Warpguru/LoRaIoT/doc/Architecture.md

# LoRaIoT - Firmware Architecture

This document is the developer reference for the LoRaIoT firmware internals.
For hardware wiring and operational guides see [`ReadMe.md`](../ReadMe.md); for worked
REST examples see [`RestApi.md`](RestApi.md#worked-examples).

---

## 1. Threading Model

To ensure that real-time RF communication never blocks the TCP/IP stack or HTTP/WebSocket
servers, LoRaIoT enforces a strict multi-threaded layout using FreeRTOS.

```
            Core 0 (System Core)                   Core 1 (Application Core)
     +---------------------------------+      +---------------------------------+
     | - WiFi Stack & LwIP             |      | - Main Arduino loop()           |
     | - ESPAsyncWebServer (Callbacks) |      |   applicationSetup/Loop()       |
     +---------------------------------+      |   (Priority 1)                  |
                      |                       | - loraTransportTask (Priority 2)|
                      |                       | - WSBroadcast (Priority 1)      |
                      |                       | - BeaconTask [REMOTE only]      |
                      |                       |   (Priority 1)                  |
                      |                       | - PingTask   (Priority 1)       |
                      |                       | - PushTask   (Priority 1)       |
                      |                       | - MqttTask [LOCAL only]         |
                      |                       |   (Priority 0)                  |
                      |                       +---------------------------------+
                      |                                        |
                      +======= [ txQueue (Serialized) ] =======+
                                         |
                                      UART2 -> E220
```

> On single-core builds all tasks run on the only available core with no affinity pinning.
> The `TASK_CREATE` macro in `src/util/src/TaskUtils.h` handles this automatically.

### Core Assignments

- **Core 0 (System Core):** Handles the high-frequency WiFi stack, TCP/IP processing, and
  non-blocking asynchronous web callbacks from `ESPAsyncWebServer` (REST API and WebSocket
  events). The WiFi stack serves one radio. In `AP_STA` mode the SoftAP and the station
  interface share it, so both interfaces run on the same channel.
- **Core 1 (Application Core):** Runs the primary application loop, the low-level
  `loraTransportTask`, WebSocket broadcast, PingTask, PushTask, and on REMOTE the
  beacon task. On LOCAL, `MqttTask` also runs here at the lowest user priority (0).

### Concurrency Rules

1. **Single UART2 Ownership:** The `loraTransportTask` is the **sole owner** of `LoRaSerial`
   (UART2). Web server callbacks on Core 0 must never write directly to UART2. The diagnostics
   engine borrows UART2 via `LoRaTransport.pause()` / `LoRaTransport.resume()`.
2. **The `txQueue` Bridge:** Any task intending to transmit calls `LoRaTransport.sendFrame()`
   or `LoRaTransport.sendRaw()`, which copies the packet into a `LoRaTxMessage` and posts it
   onto the FreeRTOS `txQueue`. The `loraTransportTask` drains the queue, executes the AUX
   handshake, and writes bytes atomically to UART2.
3. **LoRa Readiness Gate:** The `loraIsReady()` function (declared in `Application.h`) returns
   `true` only after the boot diagnostics have completed on the first `applicationLoop()` tick.
   Radio tasks (e.g. `BeaconTask`) must poll this before transmitting to avoid corrupting the
   E220 UART state during the diagnostics Mode 3 sequence.
4. **Shared State Mutexes:** All shared state structs (`LoRaState`, `SensorRegistry`,
   `ControlRegistry`, `LogBuffer`) are protected by FreeRTOS mutexes.
5. **Network I/O Tasks Must Run Below the Arduino Loop:** Any task that performs blocking
   TCP/socket I/O (e.g. `MqttTask`) must be assigned **priority 0** - strictly below the
   Arduino loop task (priority 1). See §8 for the full explanation.

---

## 2. LoRa Message Transmission and Reception Lifecycle

The diagram below details how requests from REST callbacks or background tasks are dispatched
across FreeRTOS queues to the single UART2 driver task, how AUX hardware flow control is
enforced, and how incoming frames are parsed, validated, and routed to application handlers.
The RX path shows both the synchronous response path (used when a Caller is blocking on a
reply) and the asynchronous application routing path (used for unsolicited frames such as
BEACON, DATA_ACK, and PING).

```mermaid
sequenceDiagram
    autonumber
    participant Caller as Caller Task / REST Handler
    participant Broker as LoRaBroker
    participant TxQ as txQueue (FreeRTOS Queue)
    participant Task as loraTransportTask (Core 1)
    participant E220 as Ebyte E220 Module (UART2)
    participant RxCB as onLoRaReceive Callback
    participant App as Application / Registry

    Note over Caller, E220: Outgoing Transmission Flow TX
    Caller->>Broker: loraBrokerSend(type, dstAddr, payload)
    Broker->>Broker: encodeFrame(LoRaFrame)
    Broker->>TxQ: xQueueSend(txQueue, LoRaTxMessage)
    Broker->>Broker: Block on responseSem (if waiting for reply)

    Task->>TxQ: xQueueReceive(txQueue, msg)
    Task->>E220: Poll AUX pin (wait until AUX is HIGH)
    Task->>E220: Atomic UART2 write: ADDH + ADDL + CHAN + Payload
    E220-->>Task: AUX drops LOW (transmission in flight)
    E220-->>Task: AUX rises HIGH (buffer empty)
    Task->>Task: Wait 50 ms RF guard delay (GUARD_DELAY_MS)
    Task->>Task: Increment statsTxFrames

    Note over E220, App: Incoming Reception Flow RX
    E220->>Task: UART2 RX bytes stream in
    Task->>Task: Sync scanner matches 0xAA 0x55
    Task->>Task: Accumulate header, payload, and CRC16
    Task->>Task: decodeFrame(rxBuffer) verifies CRC and DST
    Task->>Task: Increment statsRxFrames
    Task->>RxCB: onLoRaReceive(rxFrame)

    alt Frame is a RESPONSE or ACK matching a pending Caller
        RxCB->>Broker: loraBrokerOnResponse(response)
        Broker-->>Caller: Give responseSem and unblock caller
    else Unsolicited frame (BEACON, DATA_ACK, PING, DATA)
        RxCB->>App: Route by TYPE: update LoRaState, store in SensorRegistry / ControlRegistry
        App->>TxQ: Enqueue reply if required (ACK for DATA_ACK, ACK for PING, PING reply to BEACON)
    end
```

---

## 3. Boot Initialisation Sequence

The diagram below traces the exact sequence of steps from power-on (or reset after reflash)
until the node is fully ready to send and receive LoRa frames.

```mermaid
sequenceDiagram
    autonumber
    participant HW   as Hardware / Reset
    participant App  as applicationSetup
    participant Cfg  as LoRaConfig / WiFiConfig / Gateway / LogBuffer
    participant WM   as WiFiManager captive portal
    participant E220 as E220 Module UART2
    participant Task as loraTransportTask
    participant Diag as diagnosticsLoop
    participant Radio as Radio Tasks BeaconTask

    HW->>App: Power-on / reset

    Note over App,Cfg: Phase 1 - Singletons and NVS
    App->>App: statusLed.begin() - LED enters BOOTING state
    App->>Cfg: SensorRegistry.begin() / ControlRegistry.begin()
    App->>Cfg: LogBuffer.begin() - load persisted log level from NVS
    App->>Cfg: Gateway.begin() - load tier LOCAL / REMOTE from NVS
    App->>Cfg: LoRaConfig.begin() - load channel, address, cpuFreq from NVS
    App->>Cfg: WiFiConfig.begin() - load WiFi mode (STA / AP / AP_STA) and SoftAP settings from NVS
    App->>App: setCpuFrequencyMhz - apply saved CPU frequency

    Note over App,WM: Phase 2 - WiFi and Provisioning (branches on WiFiConfig mode)
    alt Mode is AP
        App->>App: WiFi.softAP - SoftAP up, WiFiManager bypassed, no captive portal
    else Mode is AP_STA
        App->>App: WiFi.softAP - SoftAP up first
        App->>WM: wm.autoConnect - join router
        Note over App,WM: If the router connection fails the node continues as SoftAP only
    else Mode is STA (default)
        App->>WM: wm.autoConnect - start WiFiManager
        alt Node is unprovisioned
            WM-->>App: Blocks - captive portal served on 192.168.4.1
            Note over WM: User selects Tier and Channel in browser
            WM->>Cfg: saveCallback - Gateway.save and LoRaConfig.save
        else Credentials already in NVS
            WM-->>App: Connects immediately, portal skipped
        end
        Note over App: A failed STA connection halts with the SOS LED
    end
    App->>App: RestService.registerRoutes - all /api/* routes wired
    App->>App: WebSocketService.begin - /ws/data handler active
    App->>App: server.begin - HTTP + WS live on port 80

    Note over App,E220: Phase 3 - E220 Hardware Init at 9600 baud Mode 3
    alt Gateway tier is configured
        App->>App: LoRaState.begin
        App->>App: LoRaTransport.setReceiveCallback
        App->>E220: LoRaTransport.begin
        E220-->>App: setMode M1=1 M0=1 - enter Config mode
        E220-->>App: Write C0 00 08 ADDH ADDL REG0 REG1 CH REG3 CRYPT_H CRYPT_L
        E220-->>App: Verify response != FF FF FF - retry up to 3x, FAULT on failure
        E220-->>App: setMode M1=0 M0=0 - Normal mode at 115200 baud
        App->>Task: TASK_CREATE loraTransportTask priority 2 - UART2 now owned
        App->>App: loraBrokerBegin - semaphore bridge initialised
        alt Tier is REMOTE
            App->>Radio: beaconTaskBegin - task created, polls loraIsReady before first TX
        end
        App->>App: statusLed setState READY
    else Tier not configured
        App->>App: statusLed setState NO_DEVICE - REST API still reachable
    end

    Note over App,Diag: Phase 4 - Boot Diagnostics and LoRa Gate
    App->>Diag: diagnosticsLoop - 6-step E220 wiring check + nanopb self-test
    Note over Diag: pause suspends loraTransportTask then resume restores it
    Diag-->>App: All steps logged to /api/log
    App->>App: loraReady = true - loraIsReady gate opens

    Note over Radio,Task: Phase 5 - Normal Operation
    Radio->>Radio: BeaconTask unblocks - loraIsReady returns true
    Radio->>Task: Enqueue BEACON frame onto txQueue
    Task->>E220: AUX handshake + atomic UART2 write
    Note over Task,E220: Node is fully operational - TX and RX active
```

---

## 4. Unified Singleton Design Pattern

The codebase is built around the **Arduino Singleton Pattern** to prevent global variable
name-shadowing collisions in C++ while presenting a clean, intuitive API. Every hardware
controller or configuration subsystem defines an underlying class with a `-Class` suffix and
exports a single global instance with a clean name:

- **`LoRaTransportClass` -> `LoRaTransport`**: Manages low-level UART2 transceiving, the
  FreeRTOS background task, and the `txQueue`.
- **`LoRaConfigClass` -> `LoRaConfig`**: Manages persistent NVS parameters (channel, address,
  CPU frequency).
- **`GatewayClass` -> `Gateway`**: Manages the persistent gateway role (`LOCAL` or `REMOTE`).
- **`LogBufferClass` -> `LogBuffer`**: Manages the multi-level (`INFO`/`DEBUG`/etc.) log ring
  buffer in RAM and provides JSON serialization.
- **`StatusLed` -> `statusLed`**: Manages the asynchronous status LED state machine.
- **`LoRaStateClass` -> `LoRaState`**: Mutex-protected per-SRC link state (duplicate
  detection, reboot detection via `boot_id`, LRU registry with 180s stale purge). Used on
  both LOCAL and REMOTE.
- **`PeerRegistry` -> `SensorRegistry`**: Manages sensor devices and metric definitions
  (owned on REMOTE, cached on LOCAL).
- **`PeerRegistry` -> `ControlRegistry`**: Manages control devices and setpoint definitions
  (owned on LOCAL, cached on REMOTE).

---

## 5. Browser Dashboard and WebSocket

Every node serves the same live dashboard at `GET /`. It is a single self-contained HTML page
(`src/LoRaIoT/src/index_html.h`, about 12 KB, inline CSS and JS, no CDN) stored in flash and sent
with `send_P()`, so it never occupies DRAM. After the page has loaded it needs no further HTTP
requests: all data arrives over one WebSocket, `ws://<host>/ws/data` (`WS_PATH` in `Server.h`).

The channel is **server push only**. The server never reads client messages (no `onEvent`
handler, no command queue), and the page sends nothing.

### Components

| Part | File | Role |
|---|---|---|
| `AsyncWebSocket ws(WS_PATH)` | `Server.cpp` | Endpoint, registered with `server.addHandler(&ws)` |
| `WebSocketService` (`wsService`) | `service/src/WebSocketService.cpp` | Owns `broadcastTask` (priority 1, 10240 B stack, `TaskRegistry` name `WSBroadcast`) |
| Dashboard page | `LoRaIoT/src/index_html.h` | WebSocket client, renders the JSON, handles link loss |

### Push path

```mermaid
sequenceDiagram
    participant B as Browser (index_html.h)
    participant W as ESPAsyncWebServer (Core 0)
    participant T as broadcastTask (1 s)
    participant R as Sensor/ControlRegistry
    B->>W: GET /
    W-->>B: INDEX_HTML from PROGMEM
    B->>W: WebSocket upgrade /ws/data
    loop every 1000 ms
        T->>T: ws->count() == 0 ? skip cycle
        T->>R: listPeers, getNodeInfo, getDeviceSlot (copies)
        T->>T: build JsonDocument, serializeJson
        T-->>B: ws->textAll(json)
        B->>B: render(), flash activity symbol
    end
```

`broadcastTask` only reads the in-RAM registry caches and never starts LoRa traffic. The air data
rate therefore does not limit the refresh rate, and values in the page are exactly as fresh as the
last frame the node received (`age_ms`, `peer_last_seen_ms_ago`).

### Payload

One JSON object per push; the full schema with an example is in
[`RestApi.md`](RestApi.md#websocket-wsdata) and in the header comment of `WebSocketService.cpp`.

| Field | Source |
|---|---|
| `uptime_s`, `tier` | `millis()`, `Gateway.getTierName()` |
| `lora` | `LoRaTransport.getStats()` (TX, RX, CRC errors, ACK loss) |
| `nodes[]` | **LOCAL:** `SensorRegistry` (sensor values cached from REMOTE nodes). **REMOTE:** `ControlRegistry` (setpoints cached from LOCAL). Same shape as `GET /api/lora/nodes/sensor` and `GET /api/lora/nodes/control`, `[]` if no peer is known |
| `echo` | `restServiceGetLastEcho()`, `null` until an echo test has run |

Design points:

- **String lifetime.** ArduinoJson stores `const char*` by pointer. `broadcastTask` therefore copies
  all `DeviceSlot` objects into a local array (`LORA_MAX_PEERS` x `DEVICE_TABLE_MAX_DEVICES`) before it
  builds the document, and keeps the array alive until `serializeJson()` returns.
- **Stack size.** That array is about 4 KB, so the stack is 10240 B. 6144 B overflowed and caused a
  stack canary panic. Check the high-water mark of `WSBroadcast` in `GET /status` when changing
  `LORA_MAX_PEERS` or the `DeviceTable` limits.
- **Idle cost.** With no client connected, the task skips the cycle before touching the registries
  or the JSON library.
- **Threading.** The task runs on Core 1 (the only core on single-core builds). The HTTP and
  WebSocket callbacks stay on Core 0 and do no LoRa or UART work, as required by the concurrency
  rules in section 1.

### Browser behaviour

| Behaviour | Implementation in the page |
|---|---|
| Reconnect | Exponential back-off, 1 s start, doubled per attempt, capped at 30 s; reset on a successful open |
| Dead-link detection | A powered-off or unplugged node sends no TCP close, so `onclose` never fires. A 1 s watchdog treats 3 s without a message as a lost link, closes the socket itself, shows "Disconnected" and starts the back-off reconnect |
| Stale data | When the link is lost the nodes are re-rendered as "unknown / link lost" with the age at the last update. The page does not claim online or offline, because it cannot know |
| Activity symbol | Flashes for 250 ms on every received message |
| Safe rendering | Node, device and metric names come from the radio link, so the DOM is built with `textContent` only, never `innerHTML` |

The online / offline badge of a node is the registry's liveness flag (`PingTask`: three unanswered
keep-alive PINGs after 90 s of silence, see [9.4](#94-ping-and-ack-both-nodes)). It is not derived from the
WebSocket. The WebSocket state ("Connected") and the node state ("online") are independent: the first
describes the link between browser and this node, the second the LoRa link between the two nodes.

### Limitations

- Read-only: the browser cannot change a setpoint over the WebSocket. Writes go through the REST API.
- `ws->cleanupClients()` is not called, so slots of clients that vanished without closing are
  reclaimed only by the async TCP stack.
- Each node shows only its own view: LOCAL does not display REMOTE's control cache and vice versa.

---

## 6. REST-to-Radio Message Flow (Control Setpoint Example)

This section traces the complete path of a write request - specifically a `POST /api/lora/nodes/control`
call on LOCAL - from the REST handler through every layer down to the physical E220 radio, and back.
It names every class, function, and file involved so a new developer can follow the code without
guessing. The data flow for sensor data (REMOTE to LOCAL) is the mirror image and follows the same
layers in the opposite direction.

### 6.1 Layer Stack

```
  POST /api/lora/nodes/control  (HTTP body: JSON)
           |
           v  Core 0 - ESPAsyncWebServer async_tcp task
  +-------------------------------+
  | RestService.cpp               |  src/service/src/RestService.cpp
  | registerRoutes() lambda       |  Validates input, writes to ControlRegistry,
  |                               |  calls loraSendDataReliable()
  +-------------------------------+
           |  calls
           v
  +-------------------------------+
  | LoRaBroker.cpp                |  src/LoRaIoT/src/LoRaBroker.cpp
  | loraSendDataReliable()        |  Encodes loraiot_Data with nanopb,
  | loraBrokerSend()              |  acquires brokerMutex, builds LoRaFrame,
  | loraBrokerWait()              |  calls LoRaTransport.sendFrame(),
  |                               |  then blocks on responseSem binary semaphore
  +-------------------------------+
           |  calls
           v
  +-------------------------------+
  | LoRaTransport.cpp             |  src/lora/src/LoRaTransport.cpp
  | sendFrame() -> sendRaw()      |  encodeFrame() -> copies LoRaTxMessage into
  |                               |  txQueue (FreeRTOS queue, depth 10)
  +-------------------------------+
           |  xQueueSend (thread-safe)
           v  Core 1 - loraTransportTask (priority 2, sole UART2 owner)
  +-------------------------------+
  | loraTransportTask loop        |  src/lora/src/LoRaTransport.cpp
  | sendRawInternal()             |  Drains txQueue, runs AUX handshake,
  |                               |  writes routing header + frame atomically to
  |                               |  LoRaSerial (HardwareSerial UART2, pins 16/17)
  +-------------------------------+
           |  GPIO 17 (TX2)
           v
  +-------------------------------+
  | E220-400T22D                  |  433 MHz LoRa, fixed transmission mode
  | RF over the air               |  Sub-packet 200 B, 62.5 kbps
  +-------------------------------+
           |  GPIO 16 (RX2) on REMOTE node
           v  Core 1 - loraTransportTask on REMOTE
  +-------------------------------+
  | loraTransportTask RX framer   |  src/lora/src/LoRaTransport.cpp
  |                               |  Sync scanner -> header accumulation ->
  |                               |  decodeFrame() CRC check -> receiveCallback
  +-------------------------------+
           |  calls
           v
  +-------------------------------+
  | Application.cpp               |  src/LoRaIoT/src/Application.cpp
  | onLoRaReceive()               |  Routes by frame TYPE; for DATA_ACK calls
  |                               |  cachedRegistry().storeData() then sendDataAck()
  +-------------------------------+
           |  sendDataAck() -> LoRaTransport.sendFrame() -> txQueue -> E220
           v  ACK frame travels back to LOCAL
  +-------------------------------+
  | onLoRaReceive() on LOCAL      |  Receives ACK frame, decodes loraiot_Ack,
  | -> loraBrokerOnDataAck()      |  calls loraBrokerOnDataAck() which
  |                               |  gives responseSem - unblocks RestService
  +-------------------------------+
           |
           v  Core 0 - RestService lambda resumes
  +-------------------------------+
  | RestService                   |  Maps BrokerResult to HTTP status
  | request->send(200/202/503/504)|  and calls request->send()
  +-------------------------------+
```

### 6.2 Concurrency Model in Detail

`ESPAsyncWebServer` delivers HTTP callbacks on Core 0 alongside the WiFi stack. The E220 module
is connected exclusively to `LoRaSerial` (`HardwareSerial LoRaSerial(2)`, UART2, GPIO 16/17).
`loraTransportTask` is created by `LoRaTransport.begin()` and is the only task that ever calls
`LoRaSerial.read()`, `LoRaSerial.write()`, or `LoRaSerial.begin()` during normal operation.
**A REST handler on Core 0 must never touch UART2 directly.**

The bridge between the two sides is:

1. **`txQueue`** - a FreeRTOS queue (depth `TX_QUEUE_SIZE` = 10, item type `LoRaTxMessage`).
   `LoRaTransport.sendRaw()` copies the encoded frame into a `LoRaTxMessage` and calls
   `xQueueSend()` with a short timeout. This is safe from any task or core.
   `loraTransportTask` drains the queue each loop iteration with `xQueueReceive()` using
   timeout 0 (non-blocking), then calls `sendRawInternal()`.
   The depth-10 capacity is **not** for pipelining multiple reliable sends - the broker
   single-slot constraint prevents that (see §6.8). It exists to absorb bursts of
   unsolicited outgoing frames (ACK replies, RESPONSE frames, BEACON frames) that
   `onLoRaReceive()` enqueues via `LoRaTransport.sendFrame()` while `loraTransportTask`
   is already inside `sendRawInternal()` for the current TX frame. These fire-and-forget
   frames bypass the broker and do not set `pendingActive`.

2. **`brokerMutex`** - a FreeRTOS mutex that guards the single in-flight slot in `LoRaBroker`.
   `loraBrokerSend()` try-acquires it with timeout 0; if it is held, it returns
   `BrokerResult::BUSY` immediately (no silent queuing). The mutex is released before the
   actual `LoRaTransport.sendFrame()` call to keep the critical section minimal.

3. **`responseSem`** - a FreeRTOS binary semaphore. After `loraBrokerSend()` returns `OK`, the
   caller immediately calls `loraBrokerWait(timeoutMs)`, which calls `xSemaphoreTake(responseSem, ticks)`.
   The calling task (the async_tcp task on Core 0) blocks here. When the matching ACK or RESPONSE
   frame arrives in `onLoRaReceive()` (running on Core 1 inside `loraTransportTask`), the receive
   path calls `loraBrokerOnDataAck()` or `loraBrokerOnResponse()`, which calls
   `xSemaphoreGive(responseSem)`, waking the waiting Core 0 task.

The default wait ceiling is `BROKER_DEFAULT_TIMEOUT_MS` = 3000 ms. The hard ceiling enforced by
the REST handler is `BROKER_MAX_TIMEOUT_MS` = 4000 ms, leaving 1000 ms headroom below the
ESP Task WDT default of 5000 ms. Calls to `loraBrokerWait()` that exceed the ceiling return
`BrokerResult::TIMEOUT`; the broker clears the pending slot so the next request is not blocked.

### 6.3 The AUX Pin Protocol

Every write to the E220 in `sendRawInternal()` follows this exact five-step sequence:

```
1. Poll AUX HIGH  - wait until digitalRead(PIN_AUX) == HIGH
                    (timeout AUX_TIMEOUT_MS = 1000 ms; warn and abort on timeout)
                    Ensures the module's internal FIFO is empty before we start.

2. Atomic write   - LoRaSerial.write(targetAddh)  <- routing header: ADDH
                    LoRaSerial.write(targetAddl)  <- routing header: ADDL (= dstAddr)
                    LoRaSerial.write(targetChan)  <- routing header: CH
                    LoRaSerial.write(data, len)   <- frame bytes (SYNC..CRC)
                    These four writes happen back-to-back with no delay between them.
                    Splitting them would risk the E220 force-flushing an incomplete frame
                    after its 2-second UART-inactivity timer.

3. Wait AUX LOW   - poll until digitalRead(PIN_AUX) == LOW
                    (timeout AUX_TRANSMIT_DETECT_TIMEOUT_MS = 50 ms; proceed on timeout)
                    AUX going LOW means the FIFO is accepting data from UART.

4. Wait AUX HIGH  - poll until digitalRead(PIN_AUX) == HIGH
                    (timeout AUX_TRANSMIT_COMPLETE_TIMEOUT_MS = 1000 ms; warn on timeout)
                    AUX returning HIGH means the FIFO has been handed to the RF chip.
                    NOTE: the last sub-packet may still be transmitting over the air
                    at this point (manufacturer §5.6.4).

5. Guard delay    - vTaskDelay(GUARD_DELAY_MS = 50 ms)
                    Mandatory air-time guard. Ensures the RF burst has finished before
                    the remote node can begin its ACK transmission.
```

Why this matters: the E220 has a 400-byte internal FIFO. If a second frame is written before the
first RF burst completes, the FIFO overflows and data is lost silently. The guard delay accounts
for the maximum air time of a maximum-length frame (200 B at 62.5 kbps takes roughly 30-50 ms
over the air).

### 6.4 DATA_ACK Retry Loop

`loraSendDataReliable()` (in `src/LoRaIoT/src/LoRaBroker.cpp`) implements reliability for
`DATA_ACK` frames:

```
maxAttempts = LORA_MAX_RETRIES + 1 = 4

for attempt in 0..3:
    if attempt > 0:
        wait random(LORA_BACKOFF_MIN_MS=20, LORA_BACKOFF_MAX_MS=200) ms
        re-arm pendingActive, pendingKind, pendingSeq (same SEQ reused)
    LoRaTransport.sendFrame(frame)          <- enqueues onto txQueue
    result = loraBrokerWait(LORA_ACK_TIMEOUT_MS=200 ms)
    if result == OK:
        outStatus = lastAckResult.status
        return OK

LoRaTransport.incrementAckLoss()            <- bumps statsAckLoss counter
outStatus = STATUS_BAD_REQUEST
return TIMEOUT
```

Key points:
- The SEQ number is assigned once before the loop and reused for all retransmissions.
  The receiver's duplicate-detection (`LoRaState.updateAndCheckDuplicate`) recognises a
  retransmitted DATA_ACK and re-sends the ACK without storing the data twice.
- Each attempt waits `LORA_ACK_TIMEOUT_MS` = 200 ms for the ACK. The timeout starts after
  the frame has been placed on `txQueue`; the actual air-time window begins a few milliseconds
  later when `loraTransportTask` drains the queue and completes the AUX handshake.
- A BUSY result (broker mutex taken) is returned immediately without entering the retry loop.
  The REST handler maps this to HTTP 503.

### 6.5 BrokerResult to HTTP Status Mapping

The `POST /api/lora/nodes/control` handler maps `loraSendDataReliable()` results to HTTP
status codes as follows (see `src/service/src/RestService.cpp`, the `/api/lora/nodes/control`
POST lambda):

| `loraSendDataReliable` result | ACK status | `delivery` field | HTTP status |
|---|---|---|---|
| `OK` | `STATUS_OK` | `"ok"` | 200 OK |
| `OK` but schema changed or `STATUS_BAD_REQUEST` ACK | `STATUS_BAD_REQUEST` | `"after_describe"` | 202 Accepted |
| `TIMEOUT` (all 4 retries failed) | - | `"timeout"` | 504 Gateway Timeout |
| `BUSY` (broker slot taken) | - | `"busy"` | 503 Service Unavailable |

- **200**: The setpoint was stored locally, transmitted, and acknowledged by REMOTE.
- **202**: The setpoint was stored locally. REMOTE acknowledged but returned `STATUS_BAD_REQUEST`,
  meaning it does not yet know the device schema. A Describe crawl has been triggered; the value
  will be pushed again by `PushTask` once the crawl completes.
- **504**: All four DATA_ACK attempts timed out with no ACK. The local value is still stored
  and will be retried by the `PushTask` when the link recovers or the next DATA_ACK opportunity
  arises.
- **503**: Another LoRa request is already in flight (the broker has a single slot matching the
  half-duplex LoRa channel). The caller should retry after a short delay.

### 6.6 Full Frame Lifecycle (DATA_ACK)

The numbered steps below correspond one-to-one with the `autonumber` labels in the sequence
diagram that follows. Each arrow in the diagram is one step.

1. REST client POSTs JSON `{"device":"Power-Supply","metrics":{"Voltage":{"value":1200,"unit":"V","scale":100}}}`.
2. `RestService` lambda (Core 0) parses the JSON, calls `ControlRegistry.registerMetric()` and
   `ControlRegistry.storeValue()` to persist the setpoint locally, and calls `ControlRegistry.toProtoData()`
   to serialise the device slot into a `loraiot_Data` protobuf struct.
3. `RestService` calls `loraSendDataReliable(dstAddr, loraiot_Data)` in `LoRaBroker`.
4. `loraSendDataReliable()` nanopb-encodes `loraiot_Data` into a byte buffer, wraps it in a
   `LoRaFrame` (TYPE=DATA_ACK, SRC=LOCAL, DST=addr, SEQ=N), acquires `brokerMutex` (try,
   timeout=0) and calls `LoRaTransport.sendFrame()`, which runs `encodeFrame()` (SYNC, VER, TYPE,
   SRC, DST, SEQ, LEN, CRC16) and `sendRaw()`, copying the result into a `LoRaTxMessage` and
   posting it onto `txQueue` via `xQueueSend()`.
5. `loraSendDataReliable()` calls `loraBrokerWait(200 ms)`, which calls
   `xSemaphoreTake(responseSem, ...)`. The async_tcp task on Core 0 blocks here until the
   semaphore is given or the timeout fires.
6. `loraTransportTask` (Core 1) drains `txQueue` with a non-blocking `xQueueReceive()`.
7. `loraTransportTask` calls `sendRawInternal()`, which first polls `PIN_AUX` until it reads HIGH
   (timeout `AUX_TIMEOUT_MS` = 1000 ms). AUX HIGH means the E220 FIFO is empty and ready.
8. `sendRawInternal()` writes the routing header (ADDH + ADDL + CH) followed immediately by the
   frame bytes (SYNC..CRC) as one atomic burst - no delays between the four `LoRaSerial.write()`
   calls.
9. E220 LOCAL drives AUX LOW: the FIFO has started accepting bytes from UART and is transferring
   them to the RF chip.
10. E220 LOCAL drives AUX HIGH: the FIFO has been handed to the RF chip. The last sub-packet may
    still be transmitting over the air at this point.
11. `sendRawInternal()` calls `vTaskDelay(GUARD_DELAY_MS = 50 ms)` to wait for the RF burst to
    finish before the channel is considered free again. `statsTxFrames` is incremented after the
    delay returns.
12. E220 LOCAL transmits the DATA_ACK frame over the 433 MHz LoRa link to E220 REMOTE.
13. E220 REMOTE outputs the received bytes on its UART2 (GPIO 16 RX2). REMOTE's
    `loraTransportTask` reads them via `LoRaSerial.read()`.
14. REMOTE's `loraTransportTask` runs the sync-byte framer: scans for `0xAA 0x55`, accumulates
    header and payload, then calls `decodeFrame()` which verifies the CRC16 and the DST address.
15. On a valid frame, `loraTransportTask` invokes `receiveCallback(rxFrame)`, which is
    `onLoRaReceive()` registered by `applicationSetup()`.
16. `onLoRaReceive()` on REMOTE decodes the `loraiot_Data` payload and calls
    `cachedRegistry().storeData()` to persist the setpoint.
17. `onLoRaReceive()` calls `sendDataAck(frame, STATUS_OK)`, which nanopb-encodes a `loraiot_Ack`,
    builds an ACK `LoRaFrame`, and calls `LoRaTransport.sendFrame()`, posting the ACK onto
    REMOTE's `txQueue`.
18. REMOTE's `loraTransportTask` picks up the ACK `LoRaTxMessage` from `txQueue` in its next
    loop iteration and calls `sendRawInternal()` to transmit it via the E220 AUX handshake.
19. E220 REMOTE transmits the ACK frame back over the 433 MHz LoRa link to E220 LOCAL.
20. E220 LOCAL outputs the ACK bytes on its UART2. LOCAL's `loraTransportTask` reads them via
    `LoRaSerial.read()`.
21. LOCAL's `loraTransportTask` runs the sync-byte framer on the incoming bytes, calls
    `decodeFrame()` (CRC check, DST check), and invokes `receiveCallback(rxFrame)`.
22. `onLoRaReceive()` on LOCAL decodes the `loraiot_Ack` payload and calls
    `loraBrokerOnDataAck(srcAddr, ack.status)`, which stores the result in `lastAckResult`,
    clears `pendingActive`, and calls `xSemaphoreGive(responseSem)`.
23. `xSemaphoreGive(responseSem)` unblocks the Core 0 async_tcp task. `loraBrokerWait()` returns
    `BrokerResult::OK` and `loraSendDataReliable()` returns `OK` with `outStatus = STATUS_OK`.
24. The REST lambda maps the result to HTTP 200 and calls `request->send(200, "application/json", json)`.

```mermaid
sequenceDiagram
    autonumber
    participant REST as REST Client
    participant Svc as RestService (Core 0)
    participant Reg as ControlRegistry
    participant Bkr as LoRaBroker
    participant TxQ as txQueue
    participant LT as loraTransportTask (Core 1)
    participant E220L as E220 LOCAL
    participant E220R as E220 REMOTE
    participant LTR as loraTransportTask REMOTE
    participant AppR as onLoRaReceive REMOTE
    participant RegR as ControlRegistry REMOTE

    REST->>Svc: POST /api/lora/nodes/control (JSON body)
    Svc->>Reg: registerMetric() + storeValue() + toProtoData()
    Svc->>Bkr: loraSendDataReliable(dstAddr, loraiot_Data)
    Bkr->>TxQ: nanopb-encode + brokerMutex(try) + sendFrame() -> sendRaw() -> xQueueSend
    Bkr->>Bkr: loraBrokerWait(200 ms) - xSemaphoreTake(responseSem)<br/>Core 0 async_tcp task BLOCKS

    LT->>TxQ: xQueueReceive (non-blocking)
    LT->>E220L: sendRawInternal: poll AUX HIGH
    LT->>E220L: atomic UART2 write (ADDH+ADDL+CH + frame bytes)
    E220L-->>LT: AUX LOW - FIFO filling
    E220L-->>LT: AUX HIGH - FIFO handed to RF chip
    LT->>LT: vTaskDelay(GUARD_DELAY_MS = 50 ms)

    E220L->>E220R: DATA_ACK frame over 433 MHz LoRa
    E220R->>LTR: UART2 RX bytes
    LTR->>LTR: sync scan 0xAA 0x55 - header + payload - decodeFrame() CRC check
    LTR->>AppR: receiveCallback(rxFrame)
    AppR->>RegR: cachedRegistry().storeData()
    AppR->>TxQ: sendDataAck() -> LoRaTransport.sendFrame() -> txQueue (REMOTE)
    LTR->>E220R: sendRawInternal - ACK frame over air
    E220R->>E220L: ACK frame over 433 MHz LoRa

    E220L->>LT: UART2 RX bytes (ACK)
    LT->>LT: framer - decodeFrame() - receiveCallback
    LT->>Bkr: loraBrokerOnDataAck(srcAddr, STATUS_OK)<br/>xSemaphoreGive(responseSem)
    Bkr-->>Svc: loraBrokerWait returns OK (Core 0 unblocks)
    Svc->>REST: HTTP 200 {"delivery":"ok"}
```

### 6.7 PingTask Indirect Path

`PingTask` (`src/LoRaIoT/src/PingTask.cpp`) does not call the REST handler but uses the same
broker. It is a standalone FreeRTOS task, so it can call `loraBrokerSend()` and block on
`loraBrokerWait()` without deadlocking the receive path.

The receive path (`loraTransportTask`) must never block waiting for the broker: doing so would
prevent the ACK from being processed, which would deadlock `loraBrokerWait()`. The solution is
the `beaconQueue` (depth `PING_QUEUE_LENGTH`): when `onLoRaReceive()` sees a BEACON it calls
`pingTaskNotifyBeacon(addr)` (posts to `beaconQueue` with timeout 0, never blocking) and returns
immediately. `pingTask` picks up the address from the queue and calls `loraBrokerSend()` /
`loraBrokerWait()` in its own context.

The same pattern applies to `pingTaskNotifyControlChange()`: the REST handler posts the node
address to `controlChangeQueue` (timeout 0, non-blocking) and returns. The `pingTask` drains
`controlChangeQueue` first on every loop iteration, before waiting on `beaconQueue`.

### 6.8 Single-Slot Guarantee and ACK Matching

#### Why only one request can be in flight at a time

The broker enforces a strict single-slot constraint regardless of the `txQueue` depth. Before
`loraSendDataReliable()` (or `loraBrokerSend()`) posts anything to `txQueue` it does:

```cpp
if (xSemaphoreTake(brokerMutex, 0) != pdTRUE) return BrokerResult::BUSY;  // mutex held
if (pendingActive)                             return BrokerResult::BUSY;  // slot occupied
// ... set pendingActive = true ...
xSemaphoreGive(brokerMutex);
LoRaTransport.sendFrame(frame);   // -> txQueue
loraBrokerWait(timeoutMs);        // blocks until ACK or timeout
```

The try-acquire (`timeout = 0`) means any concurrent caller - another REST handler, `PingTask`,
`BeaconTask` - receives `BUSY` immediately and never posts to `txQueue`. `pendingActive` stays
`true` for the entire duration of `loraBrokerWait()`, so the slot is occupied from the moment
the frame is enqueued until the ACK arrives or the timeout fires. As a result, at most one
broker-managed frame is ever present in `txQueue` at any given time.

The only frames that bypass this gate are unsolicited **fire-and-forget** replies generated
directly inside `onLoRaReceive()`: `sendPingAck()`, `sendDataAck()`, and `sendDescribeResponse()`.
These call `LoRaTransport.sendFrame()` directly, do not touch `pendingActive`, and can land in
`txQueue` concurrently with a pending broker request. `loraTransportTask` transmits them in
arrival order; the remote node will simply see them as independent frames on the channel.

#### How an ACK is matched to the pending request

`loraBrokerOnDataAck()` (called from `onLoRaReceive()` when an ACK for a DATA_ACK frame arrives)
checks only:

```cpp
bool match = pendingActive && (pendingKind == BROKER_KIND_DATA_ACK);
```

It does **not** compare `ack.acked_seq` against `pendingSeq`. This is safe for two reasons:

1. **Single-slot**: if `pendingActive` is true and `pendingKind` is `BROKER_KIND_DATA_ACK`,
   there is exactly one DATA_ACK exchange in flight. Any DATA_ACK ACK that arrives now must
   belong to it; there is no other in-flight DATA_ACK it could belong to.

2. **Same SEQ across retries**: `loraSendDataReliable()` assigns the SEQ once before the retry
   loop and reuses it for all retransmissions. So a late ACK from attempt N-1 that arrives
   during attempt N's `loraBrokerWait()` carries the same SEQ as the live attempt. The broker
   accepts it and unblocks the caller, which is the correct behaviour - one valid ACK is enough
   to declare success regardless of which physical transmission the remote node was replying to.
   The duplicate-detection on the remote side (`LoRaState.updateAndCheckDuplicate`) ensures the
   retransmitted frame is not applied to the registry twice.

A stale ACK from a **previous, already-completed** exchange cannot match because `pendingActive`
is cleared (by `loraBrokerOnDataAck()` on success, or by `loraBrokerWait()` on timeout) before
`loraSendDataReliable()` returns. By the time the next call enters, the stale ACK has long since
been received and discarded (the broker is no longer active for that kind).

---

## 7. Describe Crawl - Schema Discovery Before Data is Visible

### 7.1 Why a Crawl is Needed

LoRa frames are kept as small as possible to minimise air time and collision risk. A `DATA` or
`DATA_ACK` payload carries only compact integer values:

```
Data { device=1, values=[{metric_id=1, value=215}, {metric_id=2, value=483}] }
```

There are no strings, no units, and no human-readable names in the payload. The meaning of
`device=1`, `metric_id=1`, and the scale that turns `215` into `21.5 C` lives in a separate
**Device definition** (`Device { name="Env-Sensor", metrics=[{id=1, name="Temperature", unit="C", scale=10}, ...] }`),
which is owned by the node that produces the data and cached by the node that receives it.

Until that definition has been transferred, the receiving node cannot render the values
correctly. This transfer is the **Describe crawl**.

### 7.2 What Triggers a Crawl

Every BEACON frame (REMOTE to LOCAL) and every unicast PING frame carries an optional
`registry_rev` field - a counter that increments whenever a new device or metric is registered
on the owner node. The cache node watches this counter and schedules a crawl when it changes.

Three events set the `crawlPending` flag in `cachedRegistry()`, which `describeCrawlerLoop()`
picks up on the next `applicationLoop()` tick (all handled in `onLoRaReceive()` in
[`src/LoRaIoT/src/Application.cpp`](../src/LoRaIoT/src/Application.cpp)):

1. **New `boot_id`** - the peer has rebooted. The cache discards all state it held for that
   peer and starts a fresh crawl from device index 1. Set by `cachedRegistry().updatePeerMeta()`.
2. **`registry_rev` advanced** - a new device or metric was registered on the owner. A targeted
   crawl fetches the new definition without discarding existing ones. Set by
   `cachedRegistry().updatePeerMeta()`.
3. **DATA or DATA_ACK for an unknown device** - the cache node receives a value frame but does
   not yet have the schema for that device. `cachedRegistry().requestCrawl()` schedules an
   immediate crawl. For `DATA_ACK` the receiver additionally returns `STATUS_BAD_REQUEST` so
   the REST caller sees HTTP 202 (`"delivery":"after_describe"`).

On the sensor path, REMOTE now also calls `pingTaskNotifyControlChange(LOCAL)` whenever a
`POST /api/lora/sensor/data` increments `registry_rev`. This sends a PING to LOCAL carrying the
new `registry_rev` before the DATA frame is even transmitted, so LOCAL can start the crawl
before the data arrives rather than waiting for the next periodic BEACON.

### 7.3 The Crawl State Machine

The crawl is driven by `describeCrawlerLoop()` (in
[`src/LoRaIoT/src/DescribeCrawler.cpp`](../src/LoRaIoT/src/DescribeCrawler.cpp)), which is
called from `applicationLoop()` on every iteration. It manages one `CrawlerContext` struct:

```
IDLE ──(crawlPending detected in cachedRegistry())──► REQUESTING (deviceIdx = 1)
REQUESTING ──(RESPONSE(Device) received)──► REQUESTING (deviceIdx++)
REQUESTING ──(STATUS_BAD_REQUEST received)──► IDLE (crawl complete)
REQUESTING ──(timeout, all retries exhausted)──► IDLE (crawl aborted)
```

In `REQUESTING` state the crawler sends `REQUEST(Describe{device=deviceIdx})` directly via
`LoRaTransport.sendFrame()` - bypassing `LoRaBroker` intentionally, because the broker has a
single in-flight slot used by REST handlers and `PingTask`. The crawler manages its own
retry state (`DESCRIBE_RESPONSE_TIMEOUT_MS` = 3000 ms, `DESCRIBE_MAX_RETRIES` = 3 attempts
per device index).

`describeCrawlerOnResponse()` is called from `onLoRaReceive()` (inside `loraTransportTask`)
when a RESPONSE frame matches the in-flight Describe SEQ. It either advances `deviceIdx` and
sends the next request, or transitions back to `IDLE` on `STATUS_BAD_REQUEST`.

### 7.4 How the Owner Answers

The owner node receives `REQUEST(Describe{device=N})` in `onLoRaReceive()` and calls
`sendDescribeResponse()`, which looks up device index N in `ownedRegistry()` and replies with
`RESPONSE(Device)`. If N does not exist it replies with `STATUS_BAD_REQUEST`, signalling the
end of the device list to the crawling node.

Once the crawl-ending `STATUS_BAD_REQUEST` reply is sent, `sendDescribeResponse()` calls
`pushTaskNotifyCrawlComplete(peerAddr)`. This posts a notification to `PushTask`
([`src/LoRaIoT/src/PushTask.cpp`](../src/LoRaIoT/src/PushTask.cpp)), which then pushes the
current values of all owned devices to the peer as `DATA_ACK` frames. This ensures the cache
side receives both the schema and the current values in one crawl round.

### 7.5 Full Crawl Sequence

```mermaid
sequenceDiagram
    autonumber
    participant Own as Owner node (REMOTE for sensors / LOCAL for controls)
    participant Cache as Cache node (LOCAL for sensors / REMOTE for controls)
    participant Reg as cachedRegistry() on Cache
    participant DC as DescribeCrawler on Cache
    participant PT as PushTask on Owner

    Own->>Cache: BEACON or PING with registry_rev=N (new or changed)
    Cache->>Reg: updatePeerMeta(src, boot_id, registry_rev=N)
    Reg-->>Cache: crawlPending = true
    Note over Cache,DC: describeCrawlerLoop() picks up crawlPending on next applicationLoop() tick

    loop for deviceIdx = 1, 2, ... until BAD_REQUEST
        DC->>Own: REQUEST(Describe{device=deviceIdx}) via LoRaTransport.sendFrame()
        Own-->>DC: RESPONSE(Device{name, metrics}) or RESPONSE(STATUS_BAD_REQUEST)
        DC->>Reg: storeDevice(srcAddr, Device) - definition cached
    end

    Note over DC,Reg: STATUS_BAD_REQUEST received - crawl complete
    DC->>Reg: markCrawlComplete(addr, crawledRev)

    Own->>PT: pushTaskNotifyCrawlComplete(peerAddr)
    PT->>Cache: DATA_ACK for each owned device (current values)
    Cache->>Cache: cachedRegistry().storeData() - values now available
```

### 7.6 Visibility Delay for New Data

Because the schema must be crawled before values can be understood, there is an inherent delay
from the moment a new device or metric is registered until the data is visible on the cache
node's REST API and dashboard. The delay depends on how many devices are registered and the
current radio conditions:

| Phase | Typical duration |
|---|---|
| Owner notifies cache of new `registry_rev` | seconds: PING sent immediately on any schema change (both sensor and control paths) |
| Cache sets `crawlPending` and sends first `REQUEST(Describe{1})` | next `applicationLoop()` tick, < 10 ms |
| One `REQUEST(Describe)` round-trip at 62.5 kbps | ~100-200 ms per device (radio + processing) |
| `PushTask` pushes all device values after crawl completes | one `DATA_ACK` round-trip per device |

Both sensor and control paths now send an immediate PING carrying the new `registry_rev` the
moment a `POST` changes the schema:

- **Sensor data:** `POST /api/lora/sensor/data` calls `pingTaskNotifyControlChange(LOCAL)`
  when `registry_rev` increments, so LOCAL receives a PING and starts the crawl before the
  DATA frame even arrives over LoRa.
- **Control data:** `POST /api/lora/nodes/control` calls `pingTaskNotifyControlChange(addr)`,
  so REMOTE receives a PING and starts the crawl of LOCAL.
- **DATA with unknown device:** if a DATA frame arrives at the cache before the PING is
  processed, `cachedRegistry().requestCrawl()` in the DATA handler schedules the crawl
  immediately as a belt-and-suspenders fallback.

The BEACON interval is no longer on the critical path for new-schema latency. It remains
important for reboot detection and for the DISCOVERED/UNDISCOVERED state transition that
controls beacon rate.

Until the crawl completes, `GET /api/lora/nodes/sensor` (or `control`) on the cache node
returns the last known values or an empty list for the new device. The dashboard shows the
same cached state and will update automatically once the `PushTask` push arrives.

---

## 8. MQTT Telemetry Service

### 8.1 Overview

`MqttTask` (LOCAL tier only) runs the 256dpi `MQTTClient` library over a `WiFiClient` TCP
socket. It connects to the configured broker, publishes a retained `online` status message,
and then enters a loop that calls `client.loop()` (processes incoming MQTT packets) and
`drainPublishQueue()` (publishes queued telemetry) every `MQTT_LOOP_MS` (100 ms).

New telemetry is signalled from `loraTransportTask` via `MqttServiceClass::notifyPublish()`,
which uses a `portMUX_TYPE` spinlock to append an `(addr, deviceIdx)` entry to a fixed-size
pending array and then calls `xTaskNotifyGive()` to wake `MqttTask` early.

Incoming control setpoints (`<prefix>/Local/Remote_Node_<n>/<device>/<metric>/set`) follow the
opposite direction without ever blocking `MqttTask`: the 256dpi callback (invoked inside
`client.loop()` on `MqttTask`) only copies topic and payload into a small static queue. After
`client.loop()` returns, `MqttTask` parses it, updates `ControlRegistry` (the registry takes its
own mutex) and calls `pushTaskNotifySetpoint()`, a non-blocking queue send. `PushTask`
(priority 1) performs the blocking `loraSendDataReliable()`. `MqttTask` must never call
`loraSendDataReliable()` itself. The topic and payload format of the `/set` messages is
described in [8.6](#86-control-via-the-set-topic).

### 8.2 Why MqttTask Must Run at Priority 0

`MqttTask` must be assigned **priority 0** - strictly below the Arduino loop task (priority 1).

**The failure mode when run at priority 1:**

The boot sequence includes a diagnostics phase driven by `applicationLoop()` (the Arduino loop
task, priority 1, Core 1). `diagnosticsLoop()` calls `LoRaTransport.pause()`, which suspends
`loraTransportTask` and closes UART2, then runs the E220 wiring check, and finally calls
`LoRaTransport.resume()` to reopen UART2 and resume the transport task.

`MqttTask` is also on Core 1. With priority 1 and the MQTT broker reachable at boot, the
Arduino loop task did not complete its first `applicationLoop()` pass. The E220 check in
that pass suspends `loraTransportTask` and closes UART2 (`LoRaTransport.pause()`) and
reopens them at the end (`LoRaTransport.resume()`). If the pass never finishes, UART2 stays
closed and `loraTransportTask` stays suspended - zero LoRa RX for the whole session, and a
reboot does not help.

The symptom was observed in practice: after flashing the MQTT changes with the broker up,
`GET /api/lora/stats` showed `rx_frames=0` persistently (300+ seconds) and the log never
contained `applicationLoop: boot diagnostics complete - LoRa radio gate opened`, while
REMOTE was transmitting BEACONs every 5.5 s. With priority 0 the same code receives frames
normally.

The exact mechanism (a lock held across the blocking socket call versus plain scheduling)
is not proven; priority 0 is a verified workaround.

At priority 0, `MqttTask` is preempted by any priority-1 task the moment one becomes
runnable. The Arduino loop task always gets to complete `applicationLoop()` before `MqttTask`
resumes, and the diagnostics / LoRa gate sequence is never interrupted.

**The throughput impact is negligible:** `loraTransportTask` yields every 10 ms;
the Arduino loop yields whenever it calls `vTaskDelay` inside `describeCrawlerLoop()` and
`LoRaState.purgeStale()`. `MqttTask` gets CPU time far more often than the MQTT keepalive
interval (15 s) requires.

### 8.3 The `setOptions` Timeout Is in Milliseconds

The 256dpi `MQTTClient::setOptions(keepAlive, cleanSession, timeout)` takes `timeout` in
**milliseconds**. This timeout governs:
- How long `client.connect()` waits for a CONNACK from the broker.
- How long `client.publish()` waits for the TCP write to complete.
- The socket read loop inside `client.loop()`.

The constant `MQTT_CONNECT_TIMEOUT_MS = 5000` is in milliseconds and must be passed
**directly** to `setOptions`. Dividing it by 1000 produces `timeout = 5 ms`, which is far
too short for a WiFi TCP round-trip (typically 10-50 ms). The result is
`LWMQTT_MISSING_OR_WRONG_PACKET (-9)` on every connect attempt because the CONNACK never
arrives within 5 ms.

Correct call (in `MqttServiceClass::begin()`):
```cpp
client.setOptions(/*keepAlive=*/15, /*cleanSession=*/true,
                  /*timeout=*/MQTT_CONNECT_TIMEOUT_MS);   // 5000 ms, NOT /1000
```

### 8.4 Topic Case Sensitivity

MQTT topics are **case-sensitive**. The default prefix stored in NVS is `LoRaIoT`
(capital I, capital o, capital T as in the project name). Subscribers must match exactly:

```
# Correct
mosquitto_sub -t "LoRaIoT/#"
mosquitto_sub -t "LoRaIoT/Remote_Node_2/Today/#"

# Wrong - lowercase letters do not match
mosquitto_sub -t "LoRaIot/#"
```

The current prefix can always be verified with `GET /api/mqtt/config` (`mqttPrefix` field).

### 8.5 Topic scheme and payloads

Topic names are produced by `mqttSanitizeTopicLevel` in `MqttService.cpp`, which passes
`A-Z a-z 0-9 _ -` unchanged and replaces every other character (space, `%`, `/`, etc.)
with `_`. All values travel as scaled integers; the real value is `value / scale`. The rule
for registry names is also described in
[Sanitization Rule for Topic Levels](RestApi.md#sanitization-rule-for-topic-levels).

The node level of a REMOTE is `Remote_Node_<n>` with `n = addr - 1`. A REMOTE at LoRa address
`0x02` is therefore `Remote_Node_1` (the address is shown by `GET /api/lora/address` on the
node). The topic prefix is the `mqttPrefix` setting
([`GET /api/mqtt/config`](RestApi.md#get-apimqttconfig)); topics are case-sensitive, see
[8.4](#84-topic-case-sensitivity). The live connection state is reported by
[`GET /api/mqtt/status`](RestApi.md#get-apimqttstatus).

#### Topics published by LOCAL

LOCAL publishes each metric as a separate retained scalar topic. The payload is the real value
formatted by `mqttFormatScaledDecimal`: `215 / 10 = 21.5`, `483 / 10 = 48.3`.

| Topic | Payload | Retained | Direction | Notes |
|---|---|---|---|---|
| `LoRaIoT/Local/status` | `online` / `offline` | Yes (`online` follows `mqttRetain`; the broker publishes the `offline` last will retained) | LOCAL -> broker | Availability of LOCAL itself |
| `LoRaIoT/Remote_Node_1/status` | `online` / `offline` | Yes (`mqttRetain=1`) | LOCAL -> broker | `online` is published when REMOTE is first seen or returns from offline; `offline` when it is marked offline |
| `LoRaIoT/Remote_Node_1/Env-Sensor/Temperature` | `21.5` | Yes (`mqttRetain=1`) | LOCAL -> broker | scale 10: one decimal place |
| `LoRaIoT/Remote_Node_1/Env-Sensor/Humidity` | `48.3` | Yes (`mqttRetain=1`) | LOCAL -> broker | scale 10: one decimal place |
| `LoRaIoT/Remote_Node_1/Env-Sensor/AirPressure` | `incr.` | Yes (`mqttRetain=1`) | LOCAL -> broker | text metric: published verbatim |
| `LoRaIoT/Remote_Node_1/Env-Sensor/Firmware` | `1.10` | Yes (`mqttRetain=1`) | LOCAL -> broker | scale 100: two decimal places |
| `LoRaIoT/Remote_Node_1/Env-Sensor/Daylight` | `true` | Yes (`mqttRetain=1`) | LOCAL -> broker | boolean: stored and published as the text `true` / `false` |

All telemetry is published with `qos = 0` and `retain = true` (when `mqttRetain = 1`). All
names in this example (`Env-Sensor`, `Temperature`, `Humidity`, `AirPressure`, `Firmware`,
`Daylight`) pass the sanitizer unchanged - they contain only allowed characters. Note: the `%`
and `vers.` units are metadata only and never appear in a topic level, so they are not sanitized.

Scales 10, 100, 1000, 10000 and 100000 give 1 to 5 decimal places and scales of 1000000 and
above give 6; for any other scale (including 1 and 0) the stored integer is published
unchanged, without a decimal point. The payload of a text metric is the text verbatim.

The topic levels are built from the device and metric names of the cached definition, which
LOCAL fetches with the Describe crawl
([section 7](#7-describe-crawl---schema-discovery-before-data-is-visible)). Values of a device
or metric whose definition is not cached yet are not stored and therefore not published until
the crawl completes ([7.6](#76-visibility-delay-for-new-data)); after that the topics carry the
real names. Only a device or metric with an empty cached name is published under the fallback
levels `dev<idx>` / `m<id>`.

### 8.6 Control via the `/set` topic

LOCAL subscribes to a single wildcard filter right after connecting to the broker:

```
LoRaIoT/Local/+/+/+/set
```

This filter has five levels after the prefix (`Local`, node, device, metric, `set`); it follows
the configured `mqttPrefix`. It matches only command topics and never matches telemetry topics
(`LoRaIoT/Remote_Node_<n>/...`) or the availability topic (`LoRaIoT/Local/status`). LOCAL
subscribes to exactly one filter per broker session.

An external client publishes **one message per metric** (non-retained) to the corresponding
`/set` topic. How `MqttTask` hands the message over to `ControlRegistry` and `PushTask` is
described in [8.1](#81-overview). The JSON payload is parsed with `controlApplyMetric`, the
same function the REST handler uses. It is one metric object, identical to an entry
of the `metrics` map of [`POST /api/lora/nodes/control`](RestApi.md#post-apiloranodescontrol)
(field limits: [Request body schema and field limits](RestApi.md#request-body-schema-and-field-limits)).

#### /set Topic Pattern

```
<prefix>/Local/<node>/<device>/<metric>/set
```

For the Power Supply device on REMOTE (Node 1, address `0x02`):

| Topic | Example Payload | Direction | Notes |
|---|---|---|---|
| `LoRaIoT/Local/Remote_Node_1/Power-Supply/Voltage/set` | `{"value":1200,"unit":"V","scale":100}` | client -> LOCAL broker | numeric: scaled integer |
| `LoRaIoT/Local/Remote_Node_1/Power-Supply/Current/set` | `{"value":50,"unit":"A","scale":10}` | client -> LOCAL broker | numeric: scaled integer |
| `LoRaIoT/Local/Remote_Node_1/Power-Supply/Pwr/set` | `{"value":"on"}` | client -> LOCAL broker | text: no unit/scale needed |

`unit` and `scale` are optional in the payload (defaults: `""` and `1`). Numeric payloads must
include them if the metric is not yet registered in LOCAL's `ControlRegistry`, otherwise the
value is stored with scale 1. For an already registered metric the stored unit and scale are
kept and the ones in the payload are ignored.

The `/set` parser resolves topic names back to registry names by comparing their sanitized
forms. A device `"Power-Supply"` is stored in `ControlRegistry` as `"Power-Supply"`; the
hyphen is already valid in MQTT topic levels, so the sanitized topic level is identical to the
stored name: `Power-Supply`.

**Do not set the retain flag** (`-r`) on `/set` messages. The firmware discards any `/set`
message that arrives within `MQTT_SET_RETAINED_DRAIN_MS` (1 s) of a SUBSCRIBE, which is when
the broker replays retained messages. A retained `/set` would therefore be silently dropped on
every reconnect.

#### /set processing and limits

`MqttTask` handles each `/set` message in these steps (`messageReceived`, `processSetMessage`):

- **Dropped in the callback:** a topic of 96 characters or more (`MQTT_TOPIC_MAX_LEN`), a payload of 96 bytes or more (`MQTT_SET_PAYLOAD_MAX_LEN`), or a message that arrives while the queue already holds `MQTT_SET_QUEUE_LEN` (2) entries (logged as a warning).
- **First second after SUBSCRIBE:** every message in the window `MQTT_SET_RETAINED_DRAIN_MS` (1 s) is dropped, because the retained flag is not visible to the callback. This also drops a genuinely new, non-retained `/set` published in that first second after a (re)connect.
- **Failed SUBSCRIBE:** telemetry keeps working and the SUBSCRIBE is retried every `MQTT_SET_RESUBSCRIBE_MS` (30 s).
- **Topic:** the prefix is stripped and the rest is split into node, device, metric and `set`. A malformed topic is logged as an error and ignored; no error reply is published.
- **Node level:** `Remote_Node_<n>` with decimal digits only, no leading zero, `n` = 1..253 (LoRa address 2..254). The peer must be known in `SensorRegistry`, otherwise a warning is logged and the message is ignored.
- **Names:** resolved against `ControlRegistry` by sanitized comparison. An unknown device or metric is registered under the topic spelling. A topic name that sanitizing would change is rejected with an error log.
- **Payload:** must be a JSON object. It is passed to `controlApplyMetric`; if the schema changed, `pingTaskNotifyControlChange()` is called, then `pushTaskNotifySetpoint()`.
- **Numbers:** `value` is truncated to `int32`. Floats are not scaled; send the pre-scaled integer.
- **Not persisted:** `ControlRegistry` is held in RAM only (no NVS use in the registry or in `controlApplyMetric`). After a LOCAL reboot a `/set` registers the metric again, so `unit` and `scale` in that payload matter.

#### REMOTE-Side Result

LOCAL pushes the whole device (all metrics in `ControlRegistry` for that device) to REMOTE as
a DATA_ACK frame. REMOTE stores the values in its `ControlRegistry` cache. The IoT device on
REMOTE reads them with `GET /api/lora/nodes/control`. **Nothing is echoed back** on the `/set`
topic or on any state topic. When REMOTE's IoT device applies the setpoint and reports back via
`POST /api/lora/sensor/data`, LOCAL publishes the measured value on the normal telemetry topic
(`LoRaIoT/Remote_Node_1/...`), not on `/set`.

Each `/set` message triggers one independent LoRa push for the whole device. If the PushTask
queue (8 entries) is full, the push is dropped without retry; the next `/set` for that device
re-sends it, and a peer that comes back online or finishes a Describe crawl gets all its
devices pushed again (see [7.6](#76-visibility-delay-for-new-data) and
[9.7](#97-self-healing-after-an-outage)).

### 8.7 Worked MQTT examples

These examples continue the REST
[Worked Examples](RestApi.md#worked-examples), which also define the address placeholders
(`<broker>`, `<Local>`, `<Remote-Node-x>`, see
[Address placeholders](RestApi.md#address-placeholders)).

**Assumptions (both examples):**
- MQTT broker: `<broker>`, user and password as configured.
- MQTT prefix: `LoRaIoT` (default).
- Target REMOTE LoRa address: `0x02` (assumption - `Remote_Node_1`; confirm with
  `GET /api/lora/address` on the node). `n = addr - 1 = 1` (see [8.5](#85-topic-scheme-and-payloads)).
  Adjust `Remote_Node_<n>` in the topics below if the address differs (for example
  `Remote_Node_2` for a REMOTE at address `0x03`).
- `mqttRetain`: `1` (default) - all telemetry topics are published with `retain = true`.

#### Example 1 - Environmental Sensor: subscribe and see the topics

Scenario: the sensor board of
[REST Example 1](RestApi.md#example-1---environmental-sensor-remote-sensor-data-post) POSTs
its five readings to the REMOTE node. LOCAL receives the DATA_ACK frame over
LoRa and forwards each metric to the MQTT broker as a separate retained topic (see
[8.5](#85-topic-scheme-and-payloads)).

```bash
mosquitto_sub -h <broker> -u <user> -P <password> \
  -t 'LoRaIoT/Remote_Node_1/#' -v
```

Expected output lines (order depends on which messages arrive first):

```
LoRaIoT/Remote_Node_1/status online
LoRaIoT/Remote_Node_1/Env-Sensor/Temperature 21.5
LoRaIoT/Remote_Node_1/Env-Sensor/Humidity 48.3
LoRaIoT/Remote_Node_1/Env-Sensor/AirPressure incr.
LoRaIoT/Remote_Node_1/Env-Sensor/Firmware 1.10
LoRaIoT/Remote_Node_1/Env-Sensor/Daylight true
```

Because retain is enabled, re-running `mosquitto_sub` after the node has sent data will
immediately replay the last retained value for each topic.

#### Example 2 - Power Supply Control: set values with `mosquitto_pub`

Scenario: an MQTT client pushes the same setpoints as
[REST Example 2](RestApi.md#example-2---power-supply-control-local-control-setpoint-post)
via the `/set` topic (see [8.6](#86-control-via-the-set-topic)), without calling the REST API.

Set voltage to 12.00 V (non-retained):

```bash
mosquitto_pub -h <broker> -u <user> -P <password> \
  -t 'LoRaIoT/Local/Remote_Node_1/Power-Supply/Voltage/set' \
  -m '{"value":1200,"unit":"V","scale":100}'
```

Set current limit to 5.0 A (non-retained):

```bash
mosquitto_pub -h <broker> -u <user> -P <password> \
  -t 'LoRaIoT/Local/Remote_Node_1/Power-Supply/Current/set' \
  -m '{"value":50,"unit":"A","scale":10}'
```

Turn power on (text metric, non-retained):

```bash
mosquitto_pub -h <broker> -u <user> -P <password> \
  -t 'LoRaIoT/Local/Remote_Node_1/Power-Supply/Pwr/set' \
  -m '{"value":"on"}'
```

Turn power off:

```bash
mosquitto_pub -h <broker> -u <user> -P <password> \
  -t 'LoRaIoT/Local/Remote_Node_1/Power-Supply/Pwr/set' \
  -m '{"value":"off"}'
```

Do not add `-r` (retain); see the retain rule in [8.6](#86-control-via-the-set-topic).

### 8.8 Session, availability and hand-off details

- **Session:** the MQTT client ID is `LoRaIoT-<6 hex digits>` (low 24 bits of the efuse MAC), with `cleanSession=true` and `keepAlive=15`.
- **Last will:** only LOCAL's own `<prefix>/Local/status` has a Last Will (`offline`, retained, qos 0). There is no Last Will per REMOTE. After a LOCAL crash the retained per-peer values are corrected on the next connect (all peers are republished). A graceful disconnect, or a configuration change, publishes a retained `offline` for `<prefix>/Local/status` first.
- **Telemetry hand-off:** `notifyPublish()` keeps at most `MQTT_PENDING_MAX` (12) `(addr, deviceIdx)` entries, de-duplicated under the spinlock. When the array is full the entry is dropped and `publishDropCount` is incremented. Entries pending while the broker is not connected are discarded.
- **Per-peer status hand-off:** `mqttServiceNotifyPeerStatus()` is called by `Application.cpp` (a REMOTE comes back online, or a BEACON creates a new peer) and by `PingTask.cpp` (a REMOTE is marked offline). It is a no-op on REMOTE. There are `MQTT_PEER_STATUS_MAX` (3, equal to `LORA_MAX_PEERS`) slots. The latest state wins and notifications coalesce. The published payload is derived from `SensorRegistry.getLiveness()` at publish time. A failed publish stays pending and is retried.
- **Stack and buffer:** `MQTT_TASK_STACK_SIZE` is 5120 bytes and `MQTT_CLIENT_BUFFER_SIZE` is 256 bytes. Both are first estimates, not measured; `GET /status` reports the real stack high-water mark of `MqttTask`.

---

## 9. Runtime Behaviour

This section describes the communication lifecycle that starts after provisioning. It covers
E220 initialisation, boot diagnostics, the beacon-based discovery protocol, liveness checking,
sensor and control data flows, and the self-healing behaviour after an outage.

### 9.1 E220 Initialisation

On boot, the ESP32 configures the E220 in Mode 3 (9600 baud) writing the persistent register
block (`REG0=0xE7`, `REG1=0x00`, `REG3=0x40`), then returns to Mode 0 (115200 baud). The
`loraTransportTask` starts and owns UART2 exclusively from this point. For the register
meanings see [LoRaProtocol.md §2](LoRaProtocol.md#2-radio-configuration-normative).

### 9.2 Boot Diagnostics

On the first `applicationLoop()` tick, the 6-step E220 wiring check runs automatically
(Mode 3 register read/write/verify + nanopb + frame codec self-tests). The `loraIsReady()`
gate opens only after this completes, allowing `BeaconTask` and other radio tasks to start
transmitting.

### 9.3 BEACON and Discovery (REMOTE)

The REMOTE beacon state machine (UNDISCOVERED and DISCOVERED states, beacon intervals, revert
rule) and the LOCAL rules are specified in
[LoRaProtocol.md §8](LoRaProtocol.md#8-beacon-and-discovery).

On the first received BEACON, LOCAL registers the REMOTE node in `SensorRegistry` (via
`cachedRegistry()`) and schedules a definition crawl
([`REQUEST(Describe)`](LoRaProtocol.md#12-device-identity-and-definitions)) to learn the
REMOTE's sensor device definitions.

### 9.4 PING and ACK (both nodes)

The PING rules (keep-alive, `boot_id`, `registry_rev`) are specified in
[LoRaProtocol.md §8](LoRaProtocol.md#8-beacon-and-discovery) and
[LoRaProtocol.md §6.1](LoRaProtocol.md#61-reboot-detection-boot_id).

Both tiers run `PingTask`. LOCAL sends a liveness check
([`PING`](LoRaProtocol.md#5-message-types)) to REMOTE on BEACON reception or on demand via
REST, REMOTE sends keep-alive PINGs to LOCAL, and the sender logs the RTT of the framed `ACK`
reply.

### 9.5 Sensor Data Push (REMOTE)

- An IoT sensor on REMOTE (via its SoftAP in `AP` / `AP_STA` mode, or its LAN address in
  `STA` mode) POSTs readings to `POST /api/lora/sensor/data`. REMOTE stores them in
  `SensorRegistry` and increments `registry_rev` when the schema changes.
- When `registry_rev` changes, REMOTE immediately sends a PING to LOCAL carrying the new
  revision. LOCAL fetches the updated definitions from REMOTE over LoRa (definition crawl,
  [`REQUEST(Describe)`](LoRaProtocol.md#12-device-identity-and-definitions)), then REMOTE's
  `PushTask` pushes the current values as confirmed data frames
  ([`DATA_ACK`](LoRaProtocol.md#5-message-types)).
- A LAN client reads the values from LOCAL via `GET /api/lora/nodes/sensor?addr=2`.

See [LoRaProtocol.md §15, End-to-end scenario A](LoRaProtocol.md#end-to-end-scenario-a---iot-sensor-on-remote-softap-pushes-data-to-local)
for the full sequence diagram.

### 9.6 Control Setpoint Push (LOCAL) and Retrieval (REMOTE)

- A LAN controller POSTs a setpoint to LOCAL via `POST /api/lora/nodes/control?addr=2`. LOCAL
  stores it in `ControlRegistry` and immediately pushes it to REMOTE as a confirmed data frame
  ([`DATA_ACK`](LoRaProtocol.md#5-message-types)). If REMOTE acknowledges, LOCAL returns
  `200 {"delivery":"ok"}`.
- If REMOTE is unreachable at the time of the POST, LOCAL returns `504 {"delivery":"timeout"}`
  but **keeps the setpoint in `ControlRegistry`**. The value is re-delivered automatically
  once REMOTE comes back online (see §9.7 below).
- If REMOTE does not yet recognise the control device (e.g. after its own reboot), it tells
  LOCAL it needs the definitions first
  ([`ACK{status=BAD_REQUEST}`](LoRaProtocol.md#5-message-types)) and fetches them from LOCAL
  via a definition crawl
  ([`REQUEST(Describe)`](LoRaProtocol.md#12-device-identity-and-definitions)). LOCAL returns
  `202 {"delivery":"after_describe"}`. Once the crawl completes, LOCAL's `PushTask` re-pushes
  the stored value as a confirmed data frame
  ([`DATA_ACK`](LoRaProtocol.md#5-message-types)) without any further action from the caller.
- REMOTE caches the setpoint in its `ControlRegistry`. An IoT device on REMOTE (SoftAP or LAN
  address) reads the current setpoint via `GET /api/lora/nodes/control`.

See [LoRaProtocol.md §15, End-to-end scenario B](LoRaProtocol.md#end-to-end-scenario-b---controller-on-local-lan-pushes-a-setpoint-to-remote-iot-sensor-retrieves-it)
for the full sequence diagrams for both scenarios.

### 9.7 Self-Healing After an Outage

- **REMOTE reboots or is temporarily out of range:** REMOTE resets its `boot_id` and reverts
  to fast BEACON every 5 s. LOCAL detects the new `boot_id` on the first received BEACON,
  clears its cached sensor registry for that node, sends a liveness check
  ([`PING`](LoRaProtocol.md#5-message-types)) carrying `registry_rev` if LOCAL has control
  devices, and starts a fresh definition crawl
  ([`REQUEST(Describe)`](LoRaProtocol.md#12-device-identity-and-definitions)). Once the crawl
  completes, both `PushTask` instances re-deliver the latest values in each direction - REMOTE
  pushes its current sensor readings and LOCAL pushes its stored control setpoints. No manual
  intervention is needed.
- **LOCAL reboots:** LOCAL sends a broadcast liveness check
  ([`PING`](LoRaProtocol.md#5-message-types)) at boot carrying its new `boot_id`. REMOTE
  detects the new `boot_id`, clears its cached control registry, and fetches the definitions
  from LOCAL via a definition crawl
  ([`REQUEST(Describe)`](LoRaProtocol.md#12-device-identity-and-definitions)). After the
  crawl, LOCAL's `PushTask` re-delivers the control setpoints.
- **Temporary RF loss (no reboot):** Both nodes run `PingTask`. After 90 s of silence, each
  node sends keep-alive PINGs to the peer. After three unanswered PINGs the peer is marked
  `online: false` in the REST views. As soon as any frame is received, the peer is immediately
  revived (`online: true`) and normal operation continues with no re-crawl needed (the
  `boot_id` has not changed, so cached definitions remain valid).
- **Entry purge and re-entry:** If no frame is received for 180 s (three missed slow
  beacons), LOCAL purges the registry entry entirely. REMOTE re-enters through its fast-beacon
  cycle, which triggers a full rediscovery as described above.

### 9.8 Fixed-Mode Routing

The E220 fixed-mode routing header, broadcast address, and Mode 3 register writes are
specified in [LoRaProtocol.md §2](LoRaProtocol.md#2-radio-configuration-normative).

### 9.9 REST and WebSocket API

The REST API and the WebSocket push endpoint are documented in
[doc/RestApi.md](RestApi.md) and [Architecture.md §5](#5-browser-dashboard-and-websocket).

---

## 10. E220 Interface and Diagnostics

The pin mapping between the ESP32 and the E220 is in [ReadMe.md](../ReadMe.md#canonical-pin-mapping).

### 10.1 E220 Hardware Operating Modes

By driving the M0 and M1 pins, the ESP32 dynamically commands the E220 through different operating states:

| M1 Pin | M0 Pin | Mode | Purpose | UART Baud Rate | Description |
|:---:|:---:|:---:|---|:---:|---|
| **LOW** | **LOW** | **Mode 0** | Normal / Transceive | **115200** (Configured) | Active RF transceiving. E220 handles RF-to-UART conversion. |
| **LOW** | **HIGH** | **Mode 1** | WOR (Wake on Radio) | 115200 | Power-saving mode. Receives and transmits WOR preambles. |
| **HIGH** | **LOW** | **Mode 2** | WOR Power Save | 115200 | Puts E220 RX to sleep, waking up periodically to sense preambles. |
| **HIGH** | **HIGH** | **Mode 3** | Config / Deep Sleep | **9600** (Fixed) | Accept registers read/write commands over UART. |

### 10.2 On-Demand Diagnostics and Multi-Node Debugging

Since serial monitors can typically only focus on a single COM port at a time, LoRaIoT integrates tools to trace and isolate physical wiring faults or airframe issues over the local network.

#### The 6-Step Hardware Diagnostics Check

The diagnostics run automatically at boot and can be re-triggered at any time via REST
([`GET /api/diag/e220`](RestApi.md#get-apidiage220)):

**Trigger the check on demand** (run on each node you want to test - replace with `<LOCAL-IP>` or `<REMOTE-IP>`):
```bash
curl -s http://<LOCAL-IP>/api/diag/e220
curl -s http://<REMOTE-IP>/api/diag/e220
```
*This safely calls `LoRaTransport.pause()` to suspend the background transceiver task before touching UART2, and `LoRaTransport.resume()` when done.*

**Fetch the results from each node:**
```bash
curl -s http://<LOCAL-IP>/api/log
curl -s http://<REMOTE-IP>/api/log
```

Look for `E220 diag:` lines in the log. The six steps and their failure interpretations:

| Step | What is tested | Fail diagnosis |
|---|---|---|
| 1 | AUX reads HIGH in Mode 0 (idle) | No power to E220 (check VCC/GND) or AUX wire loose/stuck |
| 2 | AUX returns HIGH after entering Mode 3 (M1=1, M0=1) | M0 or M1 control line disconnected |
| 3 | Read all 8 registers (`C1 00 08`) - response is not `FF FF FF` | RXD/TXD lines loose, swapped, or another task is holding UART2 |
| 4 | Temp-write a different channel (`C2`), read back, compare | Register write path broken - E220 flash worn or SPI conflict |
| 5 | Temp-write original values back (`C2`), read back, compare | Values did not round-trip - likely a UART noise or timing issue |
| 6 | Return to Mode 0 - AUX rises HIGH again | M0/M1 lines intermittent or AUX stuck LOW after mode switch |

Steps 4 and 5 use the **temporary write command `0xC2`** - nothing is stored in the E220's flash, so a power cycle always restores the previous configuration.

#### Multi-Node Log Comparison

```bash
curl -s http://<local_ip>/api/log
curl -s http://<remote_ip>/api/log
```
