Warpguru/LoRaIoT/doc/private/doc-refactoring-plan.md

# Documentation Refactoring Plan

## Overview

**Goal:** a qualitative improvement of the existing documentation without adding, removing or
substantially rewriting content. Only structure, placement and references change.

**Audience split:**

- `ReadMe.md` is for a newcomer (for example on GitHub): what the project is, how it works, what
  it needs, how to get started. Plain language, with enough technical facts to judge fit.
  Detail is available through collapsible `<details>` sections, compact by default.
- All other live documents are for a technical specialist who clones the project and changes it.

**Approach:** each sub-task below is one small, separately reviewable change. After each one,
stop and wait for the user's review before starting the next.

## Decisions made by the user

- `doc/IoTProtocol.md` content is distributed to other documents and the file is then deleted.
- `doc/images/LoRaIoT-flow.png` goes into the executive summary part of `ReadMe.md`.
- ReadMe sections 1 to 3 (summary, hardware requirements, wiring) stay in `ReadMe.md`, using
  collapsible sections for a compact default view. The E220 operating-mode table moves out.
- Factual errors found in `ReadMe.md` are corrected.
- The `ReadMe.md` introduction reuses the plain wording of `FAQ.md`.
- The file name `ReadMe.md` is kept. Links pointing at `README.md` are fixed.
- The MQTT topic scheme and examples move to `doc/Architecture.md`, into the existing MQTT
  chapter (section 8) as new sub-sections. A new chapter is created only if no existing one fits.
- Unifying the example names (to those of `IoTProtocol.md`) is the LAST step, together with a
  fact verification of the MQTT content whose outcome is decided later.
- When the draw.io source of the flow diagram is corrected, the user re-exports the PNG.

## Frozen documents (decided by the user)

These files are never modified, never linked to from live documents, and nothing is moved into
them. Reading them as a source to copy facts from is allowed.

- Dead documentation: `doc/Feasibility.md`, `doc/MqttFeasibility.md`, `doc/CiFeasibility.md`
- `doc/Learnings.md` (also never referenced from other documents)
- `doc/TechDebt.md`
- `doc/private/**`, `mqtt-plan.md`
- `AGENTS.md`, `.bob/**`, `ESP/**`

Consequence: live documents currently pointing to `doc/MqttFeasibility.md`, `doc/Feasibility.md`
or `doc/Learnings.md` lose those references. Where such a pointer was the only place describing a
fact, the fact gets a live home (sub-task 7).

## Ground rules (apply to every sub-task)

- Do not renumber existing sections of a target document. Append new sections at the end, so
  existing section numbers and anchors stay valid (`FAQ.md` links to an `Architecture.md`
  anchor; `AGENTS.md` cites section numbers).
- If a target document already says the same thing, the moved text is replaced by a link. Each
  fact lives exactly once.
- Moved text is kept verbatim except for minimal link and reference fixes.
- No em dash or en dash anywhere. Use `-`.
- Do not build, flash or call `GET /reset`. Documentation work needs none of that.

## Target structure after the refactoring

| Document | Audience | Role |
|---|---|---|
| `ReadMe.md` | newcomer | Pitch, flow image, how it works, short examples, MQTT summary, dashboard, WiFi modes, hardware, getting started, antenna tips, documentation map |
| `FAQ.md` | user | unchanged except for link fixes |
| `doc/RestApi.md` | integrator | endpoints, plus request schema and limits, worked REST examples |
| `doc/Architecture.md` | specialist | threading, boot, runtime behaviour, E220 interface and diagnostics, MQTT service (threading constraints, topic scheme, examples) |
| `doc/LoRaProtocol.md` | specialist | wire spec, plus air rate and link budget theory |
| `doc/IoTProtocol.md` | - | deleted |

---

## Sub-task 1 - Correct the factual errors in ReadMe.md

**Intent:** fix known-wrong statements first, in place, so later steps are pure moves.

**Expected outcomes:** `ReadMe.md` agrees with the code and with `doc/LoRaProtocol.md`.

**Todo list:**
1. Section 5 Phase 2: change "default Channel 25 / `0x19`" to channel 23 / `0x17`. The range 0-31 is correct (`LORA_MAX_CHANNEL = 31`).
2. Section 5 Phase 3 item 7: change "After 60 s of silence" to 90 s (`PING_IDLE_THRESHOLD_MS`).
3. Re-read Phase 3 items 3 to 7 once against `doc/LoRaProtocol.md` sections 6.1 and 8 for further numeric mismatches. Report findings, fix only clear errors.
4. The introduction wording ("transparently extend local IP networks", "enterprise-grade") is NOT changed here. It is rewritten in sub-task 11.

**Relevant context:** `ReadMe.md` lines 247, 278; `src/LoRaIoT/src/LoRaConfig.h` (`LORA_DEFAULT_CHANNEL`, `LORA_MAX_CHANNEL`); `src/LoRaIoT/src/PingTask.h` (`PING_IDLE_THRESHOLD_MS`); `doc/LoRaProtocol.md` sections 6.1, 8.

**Status:** [x] done

**Note for later sub-tasks:** only lines 247 and 278 of `ReadMe.md` changed (channel 23 / `0x17`, keep-alive 90 s). Phase 3 items 3 to 7 were cross-checked and all other numbers match the code and `doc/LoRaProtocol.md` (5 s / 60 s beacons, 2 min revert = `BEACON_REVERT_TIMEOUT_MS`, 3 ping attempts, 180 s purge = `LORA_STATE_STALE_MS`). Line numbers in the "Relevant context" of later sub-tasks are unchanged because no lines were added or removed.

---

## Sub-task 2 - Move the runtime behaviour from the ReadMe into Architecture.md

**Intent:** the communication lifecycle (ReadMe section 5, Phase 3) is firmware behaviour for specialists.

**Expected outcomes:** new section "9. Runtime Behaviour" appended to `doc/Architecture.md`. In `ReadMe.md`, Phase 3 is replaced by a short summary and a link.

**Todo list:**
1. Append "9. Runtime Behaviour" with the content of Phase 3 items 1 to 7 (E220 init, boot diagnostics, beacon and discovery, ping and ack, sensor push, control push, self-healing).
2. Where `doc/LoRaProtocol.md` sections 6.1, 8 or 15 already contain the same rule or sequence, reduce the text to a link. Keep text that exists only in the ReadMe (for example the three self-healing scenarios and the `200/202/504` delivery results).
3. Fix relative links inside the moved text (`doc/LoRaProtocol.md` becomes `LoRaProtocol.md`).
4. Replace Phase 3 in `ReadMe.md` with a 3 to 4 line summary and a link. Phase 1 and 2 (build, flash, provision) stay.
5. Phase 3 item 8 (fixed-mode routing) is already in `doc/LoRaProtocol.md` section 2: link only. Item 9 (REST and WebSocket) is already in `doc/RestApi.md` and `Architecture.md` section 5: link only.

**Relevant context:** `ReadMe.md` lines 254-283; `doc/Architecture.md` (currently ends with section 8); `doc/LoRaProtocol.md` sections 2, 6.1, 8, 15.

**Status:** [x] done

**Note for later sub-tasks:** `ReadMe.md` Phase 3 is now 11 lines (was 30 lines). The heading
"### Phase 3: Run & Communicate" is at approximately line 254; the removal of ~22 lines
shifts everything from line 287 onward downward. Sub-task 3 uses `ReadMe.md` lines 197-207
and 445-485 - those lines are now approximately 197-207 and 423-463 respectively. Re-locate
by heading ("E220 Hardware Operating Modes", "7. On-Demand Diagnostics") rather than by line
number. `doc/Architecture.md` section 9 starts at line 951; the file previously ended at
line 948.

---

## Sub-task 3 - Move the E220 interface and diagnostics into Architecture.md

**Intent:** the E220 operating-mode table and the 6-step diagnostics are specialist material.

**Expected outcomes:** new section "10. E220 Interface and Diagnostics" appended to `doc/Architecture.md`. `ReadMe.md` keeps the pin mapping table (a builder needs it) and gets a short troubleshooting pointer.

**Todo list:**
1. Move the ReadMe "E220 Hardware Operating Modes" table to the new section. Do not replace it with a link into `doc/Feasibility.md` (frozen).
2. Move ReadMe section 7 (6-step diagnostics table, the `LoRaTransport.pause()/resume()` note, multi-node log comparison) to the same section.
3. In `ReadMe.md`, replace section 7 with a 3 line "Troubleshooting" text: call `GET /api/diag/e220`, read `GET /api/log`, link to the Architecture section.

**Relevant context:** `ReadMe.md` lines 197-207 and 445-485; `doc/Architecture.md`; `doc/RestApi.md` (`GET /api/diag/e220`).

**Status:** [x] done

**Note for later sub-tasks:** `doc/Architecture.md` now ends with "## 10. E220 Interface and Diagnostics" (10.1 E220 Hardware Operating Modes; 10.2 On-Demand Diagnostics and Multi-Node Debugging with the 6-step table, `pause()/resume()` note, `0xC2` note and Multi-Node Log Comparison). It links to `RestApi.md#get-apidiage220` and `../ReadMe.md#canonical-pin-mapping`. Em dashes in the moved text were replaced by `-`. In `ReadMe.md` the heading "### E220 Hardware Operating Modes" (section 3) is kept with a one-line pointer to Architecture §10.1, and "## 7. On-Demand Diagnostics & Multi-Node Debugging" became "## 7. Troubleshooting" (3 lines, links to Architecture §10.2). ReadMe section numbering is unchanged; no file links to the old section 7 or E220 mode table anchors. ReadMe section 7 shrank from about 36 to 5 lines, so section 8 and the glossary appendix moved up by about 31 lines: re-locate by heading. Sub-task 11 may fold "7. Troubleshooting" and the one-line "E220 Hardware Operating Modes" pointer into the new structure (and must then keep the links in the Architecture section 10 intro, which targets `ReadMe.md#canonical-pin-mapping`, valid). `AGENTS.md` line 121 cites `README.md` §3 for the pin mapping (frozen, unchanged; the pin mapping is still in section 3).

---

## Sub-task 4 - Move the air rate theory into LoRaProtocol.md

**Intent:** link budget and register constants are specialist material; antenna placement stays for installers.

**Expected outcomes:** new sub-section "Link budget and air rate selection" appended to section 18 of `doc/LoRaProtocol.md` (last section, nothing renumbered). `ReadMe.md` keeps the antenna rule and one sentence on air rate with a link.

**Todo list:**
1. Move ReadMe section 8 rule 2 (link budget, dB figures, `REG0` constants) into section 18.
2. Keep the existing `PUT /api/lora/airrate` reference.
3. Keep rule 1 (parallel-tilt antenna rule) in `ReadMe.md`.
4. ReadMe keeps one sentence: lowering the air rate trades throughput for range, with a link to `doc/LoRaProtocol.md` section 18.

**Relevant context:** `ReadMe.md` lines 486-502; `doc/LoRaProtocol.md` section 18.

**Status:** [x] done

**Note for later sub-tasks:** `doc/LoRaProtocol.md` section 18 now ends with sub-section `### Link budget and air rate selection` (lines 781-794), covering the mathematical coupling of sensitivity to spreading factor/bandwidth, `REG0` constants (`REG0_AIR_DATA_RATE_62K5` to `REG0_AIR_DATA_RATE_2K4`, $+14\text{ dB}$ link budget increase), the $6\text{ dB}$ range/penetration doubling rule, `PUT /api/lora/airrate`, and internal links to the test results and timeout note above. In `ReadMe.md` section 8, rule 1 (`1. The Parallel-Tilt Antenna Rule`) remains unchanged; rule 2 (`2. Dropping Air Data Rate for Link Budget Gains`) was reduced to two sentences stating that lowering air rate via `PUT /api/lora/airrate` trades throughput for range and linking to `doc/LoRaProtocol.md#link-budget-and-air-rate-selection`. No lines were added/removed from ReadMe.md that would affect earlier sections; section 8 is now lines 427-440.

---

## Sub-task 5 - Move the request schema and field limits into RestApi.md

**Intent:** the "Request Body Schema and Field Limits" part of `IoTProtocol.md` is API reference material.

**Expected outcomes:** `doc/RestApi.md` documents the shared JSON body, field table, topic-level sanitization rule and capacity limits table (with `DeviceTable.h` constants), next to the two endpoints that use it.

**Todo list:**
1. Add the schema, field reference, sanitization rule and capacity table as a sub-section of `POST /api/lora/sensor/data`. Refer to it from `POST /api/lora/nodes/control` (no duplication).
2. Merge with the existing "Value types" list in `POST /api/lora/sensor/data`. Remove only exact duplicates.
3. Keep the HTTP 400 and `rejected` array behaviour description.
4. Add an anchor that other documents can link to.

**Relevant context:** `doc/IoTProtocol.md` lines 30-90; `doc/RestApi.md` sections `POST /api/lora/sensor/data`, `POST /api/lora/nodes/control`; `src/registry/src/DeviceTable.h`.

**Status:** [x] done

**Note for later sub-tasks:** the schema now lives in `doc/RestApi.md` as `### Request body schema and field limits`, the last sub-section of `POST /api/lora/sensor/data` (with `#### Field Reference`, `#### Sanitization Rule for Topic Levels` and the `<details>` capacity table). GitHub anchor to link to: `#request-body-schema-and-field-limits` (from `doc/Architecture.md` and other documents: `RestApi.md#request-body-schema-and-field-limits`). The old "Value types" lists in `POST /api/lora/sensor/data` and `POST /api/lora/nodes/control` were replaced by one-line references to that anchor. The sub-section mentions the MQTT `/set` payload and topic levels neutrally and has no link to MQTT anchors: sub-task 7 may add a link from the Sanitization Rule to Architecture 8.5/8.6. Sub-task 6 should link its examples to this anchor. The two `MqttFeasibility.md` pointers in `RestApi.md` (in `POST /api/lora/nodes/control` and in the MQTT section) are untouched (sub-task 7). `doc/IoTProtocol.md` was not modified.

---

## Sub-task 6 - Move the REST worked examples into RestApi.md

**Intent:** curl examples, expected responses and notes of `IoTProtocol.md` belong with the API reference.

**Expected outcomes:** new section "Worked Examples" at the end of `doc/RestApi.md` with the placeholder table (`<Local>`, `<Remote-Node-x>`, `<broker>`), the REST part of Example 1 (sensor POST) and Example 2 (control POST), bash and PowerShell variants, expected responses and notes.

**Todo list:**
1. Append "Worked Examples". Keep the `<details>` blocks as in the source.
2. Move the placeholder reference.
3. Move the example responses, status code notes (`200`, `202`, `503`, `504`) and the notes lists. Skip MQTT parts (sub-task 7).
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
