Warpguru/LoRaIoT/doc/private/mqtt-plan.md

# MQTT Integration Implementation Plan

**Goal:** Implement lightweight MQTT telemetry forwarding (LoRa to MQTT) and setpoint subscription (MQTT to LoRa) on the LOCAL node using a hierarchical topic tree and non-blocking FreeRTOS architecture.

---

## Architecture Overview

- **Target Node:** LOCAL node only (REMOTE nodes remain unaware of MQTT).
- **Placement:** `MqttService.cpp/.h` in `src/service/` (consistent with `WebSocketService`, `RestService`, and `WiFiConfig`).
- **Core Library:** `256dpi/MQTT @ ^2.5.3` (plain TCP, synchronous client inside dedicated task, ~10 KB flash).
- **Threading Model:** Dedicated FreeRTOS task `mqttTask` (priority 0 on Core 1, strictly below the Arduino loop task; priority 1 stalled the LoRa boot sequence, see `doc/Learnings.md` chapter 1) with non-blocking spinlock pending-set hand-off (depth 12 with de-duplication) bridging `loraTransportTask` and MQTT network I/O.
- **Failure Isolation:** Non-blocking pending-set hand-off ensures an unreachable or failing MQTT broker never blocks LoRa reception (`loraTransportTask`), the WiFi stack, or Core 0 web callbacks.
- **Topic Scheme:** `<prefix>/<node>/<device>/<metric>` where `<node>` is textual `Remote_Node_<n>` and `n` is the dashboard node number (`n = LoRa address - 1`, so `REMOTE (Node 1)` = address 0x02 = `Remote_Node_1`, e.g. `LoRaIoT/Remote_Node_1/SensorA/Voltage`), publishing scaled real decimal strings with `retain = true`.
- **Availability / LWT:** Broker Last Will and Testament (LWT) on `<prefix>/Local/status` (`offline` on ungraceful disconnect, `online` on connect) and per-node availability on `<prefix>/Remote_Node_<n>/status`.
- **Control Path:** Setpoint subscription on `<prefix>/Local/+/+/+/set` (topic `<prefix>/Local/Remote_Node_<n>/<device>/<metric>/set`, JSON payload identical to one metric object of `POST /api/lora/nodes/control`) translating into `ControlRegistry` updates and a per-device `PushTask` hand-off that transmits a `DATA_ACK` frame.

---

## Sub-Tasks

### Sub-Task 1: Library Dependency and MqttService Task Engine

- **Intent:** Add `256dpi/arduino-mqtt` library and implement minimal `MqttService` skeleton with a dedicated Core 1 FreeRTOS task to measure exact flash and heap usage before further feature implementation.
- **Expected Outcomes:**
  - `platformio.ini` includes `256dpi/MQTT @ ^2.5.3`.
  - `src/service/src/MqttService.h` and `src/service/src/MqttService.cpp` scaffolded.
  - `mqttServiceBegin()` invoked only on LOCAL nodes in `Application.cpp:applicationSetup()`.
  - Task `mqttTask` runs on Core 1 (`TASK_CREATE`, stack size 4096 bytes, priority 0) and registers with `TaskRegistry.add()`.
  - Connection management with exponential backoff and LWT (`<prefix>/Local/status` = `offline`).
  - Flash image size and heap headroom verified immediately after linking.
- **Todo List:**
  - [x] Add `256dpi/MQTT @ ^2.5.2` to `platformio.ini` under `[env]` `lib_deps`.
  - [x] Create `src/service/src/MqttService.h` and `src/service/src/MqttService.cpp`.
  - [x] Implement `mqttServiceBegin()` and hook into `Application.cpp:applicationSetup()`.
  - [x] Implement `mqttTask` skeleton with `TASK_CREATE`, `TaskRegistry.add()`, and `MQTTClient` instance.
  - [x] Configure LWT and broker connection loop.
  - [x] Verify build size and resource footprint on hardware (to be done by developer).
- **Relevant Context:**
  - [`src/service/src/WebSocketService.cpp`](src/service/src/WebSocketService.cpp:1)
  - [`src/util/src/TaskUtils.h`](src/util/src/TaskUtils.h:1) (`TASK_CREATE` macro)
- **Status:** `[x] done (LWT, connection loop, NVS config, REST API implemented; awaiting developer build & resource check)`

---
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
