Warpguru/LoRaIoT/doc/images/ESP32-WROOM-32.jpg

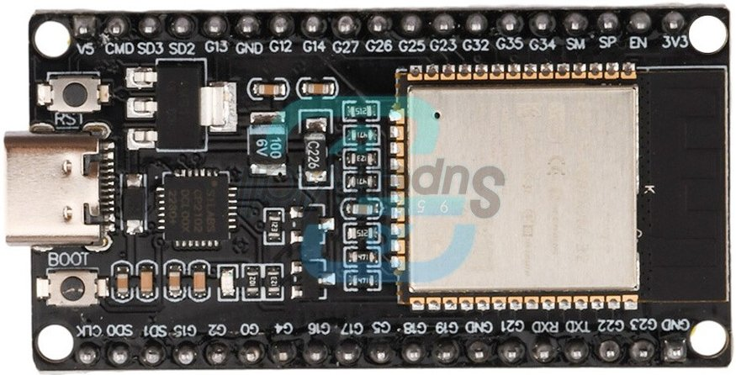
doc/images/ESP32-WROOM-32.jpg
