Warpguru/LoRaIoT/doc/images/ESP32-WROOM-32.webp

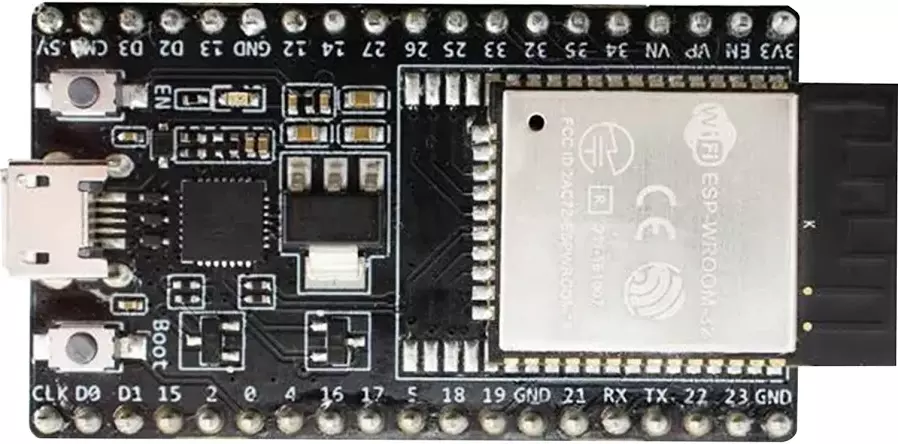
doc/images/ESP32-WROOM-32.webp
