Warpguru/LoRaIoT/src/lora/src/LoRaTransport.cpp

#include "LoRaTransport.h"

#include <Arduino.h>
#include <HardwareSerial.h>

#include "../../diagnostics/src/TaskRegistry.h"
#include "../../util/src/LogBuffer.h"
#include "../../util/src/StatusLed.h"
#include "../../util/src/TaskUtils.h"
#include "../../LoRaIoT/src/LoRaConfig.h"

// Hardware Serial object mapped to UART2
HardwareSerial LoRaSerial(2);

// The actual global memory allocation for the LoRa transport layer singleton.
// All application-level files include "LoRaTransport.h" and interact with this object.
LoRaTransportClass LoRaTransport;

static constexpr size_t HEX_LOG_BUFFER_SIZE = 128;  // Output buffer for logHex()

// Label and REG0 bits of every AirRate, indexed by the enum ordinal (which is what is stored in NVS).
struct AirRateInfo {
  const char* name;
  uint8_t     reg0;
};
static constexpr AirRateInfo AIR_RATE_TABLE[LoRaTransportClass::AIR_RATE_COUNT] = {
    {"2.4k",  LoRaTransportClass::REG0_AIR_DATA_RATE_2K4},    // AIR_RATE_2K4
    {"4.8k",  LoRaTransportClass::REG0_AIR_DATA_RATE_4K8},    // AIR_RATE_4K8
    {"9.6k",  LoRaTransportClass::REG0_AIR_DATA_RATE_9K6},    // AIR_RATE_9K6
    {"19.2k", LoRaTransportClass::REG0_AIR_DATA_RATE_19K2},   // AIR_RATE_19K2
    {"38.4k", LoRaTransportClass::REG0_AIR_DATA_RATE_38K4},   // AIR_RATE_38K4
    {"62.5k", LoRaTransportClass::REG0_AIR_DATA_RATE_62K5},   // AIR_RATE_62K5
};

const char* LoRaTransportClass::airRateName(AirRate rate) {
  return AIR_RATE_TABLE[rate].name;
}

uint8_t LoRaTransportClass::airRateReg0(AirRate rate) {
  return AIR_RATE_TABLE[rate].reg0;
}

bool LoRaTransportClass::airRateFromName(const char* name, AirRate& out) {
  if (name == nullptr) {
    return false;
  }
  for (uint8_t i = 0; i < AIR_RATE_COUNT; i++) {
    if (strcmp(AIR_RATE_TABLE[i].name, name) == 0) {
      out = static_cast<AirRate>(i);
      return true;
    }
  }
  return false;
}

/**
 * Reusable helper to format and log a byte array in hexadecimal.
 */
static void logHex(const char* prefix, const uint8_t* data, size_t len) {
  char hex[HEX_LOG_BUFFER_SIZE] = {0};
  size_t pos = 0;
  for (size_t i = 0; i < len && pos + LoRaTransportClass::HEX_ENTRY_SIZE < sizeof(hex); i++) {
    pos += snprintf(hex + pos, sizeof(hex) - pos, "%02X ", data[i]);
  }
  Log_info("%s %s", prefix, hex);
}

bool LoRaTransportClass::configureE220() {
  const AirRate airRate = LoRaConfig.getAirRate();
  Log_info("Configuring E220 module registers permanently in Mode 3 (air rate %s)...", airRateName(airRate));
  setMode(HIGH, HIGH); // M1=1, M0=1

  // Start serial at 9600 baud (fixed for E220 config mode). end() first: at runtime the
  // port is open at NORMAL_BAUD; at boot it is a harmless no-op.
  LoRaSerial.end();
  LoRaSerial.begin(CONFIG_BAUD, SERIAL_8N1, PIN_RX, PIN_TX);

  // Construct the command payload to permanently configure the E220.
  // Using explicit bitwise-OR options makes the config list completely self-documenting.
  // Split the 16-bit key into the two CRYPT register bytes.
  // key == 0 leaves CRYPT_H=0x00 / CRYPT_L=0x00, which disables E220 encryption.
  const uint16_t loraKey = LoRaConfig.getKey();
  uint8_t configCmd[CONFIG_CMD_LEN] = {
      CMD_WRITE_PERSISTENT,
      REG_START_ADDR,
      REG_WRITE_COUNT,
      ADDH,
      LoRaConfig.getAddress(),
      (REG0_UART_BAUD_115200 | REG0_PARITY_8N1 | airRateReg0(airRate)),
      (REG1_SUB_PACKET_200B | REG1_RSSI_NOISE_DISABLE | REG1_POWER_22DBM),
      LoRaConfig.getChannel(),
      (REG3_MODE_FIXED | REG3_RSSI_BYTE_DISABLE | REG3_LBT_DISABLE),
      static_cast<uint8_t>(loraKey >> 8),    // CRYPT_H
      static_cast<uint8_t>(loraKey & 0xFF)   // CRYPT_L
  };

  logHex("LoRaTransport::begin - Sent config cmd:", configCmd, CONFIG_CMD_LEN);

  // Write config and verify response; retry up to LORA_MAX_RETRIES times on
  // FF FF FF error reply or short read.
  bool configOk = false;
  for (uint8_t attempt = 0; attempt < LORA_MAX_RETRIES; attempt++) {
    // AUX must be HIGH and stable before writing config data
    unsigned long settleStart = millis();
    while (digitalRead(PIN_AUX) == LOW) {
      if (millis() - settleStart > AUX_TIMEOUT_MS) {
        Log_error("LoRaTransport::begin - Timeout waiting for AUX HIGH before config write (attempt %u/%u)",
                  attempt + 1, (uint8_t)LORA_MAX_RETRIES);
        break;
      }
      delay(POLL_INTERVAL_MS);
    }
    delay(GUARD_SETTLE_DELAY_MS);

    // Write configuration command
    LoRaSerial.write(configCmd, CONFIG_CMD_LEN);
    delay(TRANSMIT_SETTLE_DELAY_MS);

    // Read response (should echo C1 00 08 ...)
    uint8_t response[CONFIG_RESPONSE_LEN] = {0};
    size_t bytesRead = LoRaSerial.readBytes(response, CONFIG_RESPONSE_LEN);

    logHex("LoRaTransport::begin - Config response:", response, bytesRead);

    if (bytesRead >= CONFIG_RESPONSE_LEN && response[0] != ERROR_REPLY_BYTE) {
      Log_info("LoRaTransport::begin - E220 configuration applied successfully (attempt %u/%u).",
               attempt + 1, (uint8_t)LORA_MAX_RETRIES);
      configOk = true;
      break;
    }

    Log_error("LoRaTransport::begin - Invalid config response (attempt %u/%u); retrying...",
              attempt + 1, (uint8_t)LORA_MAX_RETRIES);
    delay(GUARD_SETTLE_DELAY_MS);
  }

  // Return to Mode 0 (Normal operation: M1=0, M0=0) and configure normal baud rate,
  // also after a failure so the radio keeps running with its previous registers.
  setMode(LOW, LOW);
  LoRaSerial.end();

  // Re-open serial at 115200 baud (as configured in REG0)
  LoRaSerial.begin(NORMAL_BAUD, SERIAL_8N1, PIN_RX, PIN_TX);
  return configOk;
}

void LoRaTransportClass::requestReconfigure() {
  reconfigRequested.store(true);
}

void LoRaTransportClass::begin() {
  Log_info("Initializing LoRa transport layer infrastructure...");

  // 1. Configure E220 hardware control pins
  pinMode(PIN_M0, OUTPUT);
  pinMode(PIN_M1, OUTPUT);
  pinMode(PIN_AUX, INPUT);

  // 2. Perform E220 permanent configuration in Mode 3 (Deep Sleep / Config).
  // On persistent failure set FAULT LED and suspend this task forever
  // (same pattern as WiFi failure in AGENTS.md).
  if (!configureE220()) {
    Log_error("LoRaTransport::begin - E220 config failed after %u attempts. Halting.", (uint8_t)LORA_MAX_RETRIES);
    statusLed.setState(LedState::FAULT);
    vTaskSuspend(NULL);
  }

  // 3. Create the FreeRTOS Queue for outgoing transmissions
  txQueue = xQueueCreate(TX_QUEUE_SIZE, sizeof(LoRaTxMessage));
  if (txQueue == nullptr) {
    Log_error("LoRaTransport::begin - Failed to create TX Queue!");
  }

  // 4. Create the statistics mutex
  statsMutex = xSemaphoreCreateMutex();
  if (statsMutex == nullptr) {
    Log_error("LoRaTransport::begin - Failed to create stats mutex!");
  }

  // 5. Spawn background transceiver task (TASK_CREATE pins task to Core 1 on dual-core)
  TASK_CREATE(loraTransportTask, "LoRaTransTask", TASK_STACK_SIZE, this, TASK_PRIORITY, &transportTaskHandle);
  TaskRegistry.add("LoRaTransTask", transportTaskHandle, TASK_STACK_SIZE);

  Log_info("LoRa transport layer task started.");
}

void LoRaTransportClass::sendRaw(uint8_t destAddr, const uint8_t* data, size_t len) {
  if (data == nullptr || len == 0 || txQueue == nullptr) return;

  // Truncate to maximum sub-packet frame capacity
  size_t transmitLen = (len > LORA_MAX_FRAME_LEN) ? LORA_MAX_FRAME_LEN : len;

  LoRaTxMessage msg;
  msg.destAddr = destAddr;
  memcpy(msg.data, data, transmitLen);
  msg.len = transmitLen;

  // Thread-safe post to outgoing queue; do not block indefinitely if queue is full
  if (xQueueSend(txQueue, &msg, pdMS_TO_TICKS(TASK_DELAY_MS)) != pdPASS) {
    Log_warn("LoRaTransport::sendRaw - Outgoing queue full! Frame dropped.");
  }
}

bool LoRaTransportClass::sendFrame(const LoRaFrame& frame) {
  uint8_t encoded[LORA_MAX_ENCODED_LEN];
  size_t  encodedLen = 0;
  if (!encodeFrame(frame, encoded, encodedLen)) {
    Log_error("LoRaTransport::sendFrame - encodeFrame failed (payload len=%u)", frame.len);
    return false;
  }
  sendRaw(frame.dst, encoded, encodedLen);
  return true;
}

void LoRaTransportClass::setReceiveCallback(LoRaReceiveCallback cb) {
  receiveCallback = cb;
}

LoRaStats LoRaTransportClass::getStats() const {
  LoRaStats snap = {0, 0, 0, 0};
  if (statsMutex == nullptr) return snap;
  xSemaphoreTake(statsMutex, portMAX_DELAY);
  snap.txFrames  = statsTxFrames;
  snap.rxFrames  = statsRxFrames;
  snap.crcErrors = statsCrcErrors;
  snap.ackLoss   = statsAckLoss;
  xSemaphoreGive(statsMutex);
  return snap;
}

void LoRaTransportClass::resetStats() {
  if (statsMutex == nullptr) {
    return;
  }
  xSemaphoreTake(statsMutex, portMAX_DELAY);
  statsTxFrames  = 0;
  statsRxFrames  = 0;
  statsCrcErrors = 0;
  statsAckLoss   = 0;
  xSemaphoreGive(statsMutex);
}

void LoRaTransportClass::incrementAckLoss() {
  if (statsMutex == nullptr) {
    return;
  }
  xSemaphoreTake(statsMutex, portMAX_DELAY);
  statsAckLoss++;
  xSemaphoreGive(statsMutex);
}

void LoRaTransportClass::pause() {
  if (transportTaskHandle != nullptr) {
    vTaskSuspend(transportTaskHandle);
  }
  LoRaSerial.end();
}

void LoRaTransportClass::resume() {
  LoRaSerial.begin(NORMAL_BAUD, SERIAL_8N1, PIN_RX, PIN_TX);
  if (transportTaskHandle != nullptr) {
    vTaskResume(transportTaskHandle);
  }
}

void LoRaTransportClass::sendRawInternal(uint8_t destAddr, const uint8_t* data, size_t len) {
  // 1. Mandatory AUX pin check: poll AUX HIGH (wait until E220 is idle)
  unsigned long timeoutStart = millis();
  while (digitalRead(PIN_AUX) == LOW) {
    if (millis() - timeoutStart > AUX_TIMEOUT_MS) {
      Log_warn("LoRaTransport::sendRawInternal - Timeout waiting for AUX HIGH (idle) before write");
      return;
    }
    vTaskDelay(pdMS_TO_TICKS(POLL_INTERVAL_MS));
  }

  // 2. Prepend the Fixed Mode routing header: [ADDH][ADDL][CHAN]
  // For broadcast (0xFF), E220 fixed-transmission uses ADDH=0xFF, ADDL=0xFF.
  // For unicast, ADDH is always 0x00 (all nodes share the same high byte).
  const uint8_t targetAddh = (destAddr == LORA_ADDR_BROADCAST) ? LORA_ADDR_BROADCAST : ADDH;
  const uint8_t targetAddl = destAddr;
  const uint8_t targetChan = LoRaConfig.getChannel();

  // Print diagnostics for transmission routing
  if (len > 0) {
    char dbgPrefix[DEBUG_PREFIX_SIZE];
    snprintf(dbgPrefix, sizeof(dbgPrefix), "LoRa TX: target=[0x%02X, 0x%02X] ch=0x%02X payload:", targetAddh, targetAddl, targetChan);
    logHex(dbgPrefix, data, len);
  }

  // Write routing header and payload atomically
  LoRaSerial.write(targetAddh);
  LoRaSerial.write(targetAddl);
  LoRaSerial.write(targetChan);
  LoRaSerial.write(data, len);

  // 3. Wait for AUX to go LOW (E220 begins RF transmission from buffer)
  timeoutStart = millis();
  while (digitalRead(PIN_AUX) == HIGH) {
    if (millis() - timeoutStart > AUX_TRANSMIT_DETECT_TIMEOUT_MS) {
      break;
    }
    vTaskDelay(pdMS_TO_TICKS(POLL_INTERVAL_MS));
  }

  // 4. Wait for AUX to go HIGH again (E220 finished buffer transmission)
  timeoutStart = millis();
  while (digitalRead(PIN_AUX) == LOW) {
    if (millis() - timeoutStart > AUX_TRANSMIT_COMPLETE_TIMEOUT_MS) {
      Log_warn("LoRaTransport::sendRawInternal - Timeout waiting for AUX HIGH (transmit complete)");
      break;
    }
    vTaskDelay(pdMS_TO_TICKS(POLL_INTERVAL_MS));
  }

  // 5. Add 50ms guard delay (required E220 air-transmission finish time)
  vTaskDelay(pdMS_TO_TICKS(GUARD_DELAY_MS));
}

void LoRaTransportClass::setMode(uint8_t m0, uint8_t m1) {
  digitalWrite(PIN_M0, m0);
  digitalWrite(PIN_M1, m1);

  // Wait for AUX to rise to HIGH, ensuring E220 completes transition
  unsigned long timeoutStart = millis();
  while (digitalRead(PIN_AUX) == LOW) {
    if (millis() - timeoutStart > AUX_TIMEOUT_MS) {
      break;
    }
    delay(POLL_INTERVAL_MS);
  }
  delay(GUARD_SETTLE_DELAY_MS); // AUX must stay HIGH >= 2 ms before UART data is accepted
}

void LoRaTransportClass::loraTransportTask(void* param) {
  LoRaTransportClass* self = static_cast<LoRaTransportClass*>(param);
  Log_info("LoRa background transport task loop initialized.");

  // Binary sync-byte framer state (static = lives on the heap, not the 4 kB task stack).
  // The framer scans for 0xAA 0x55, accumulates exactly one frame worth of bytes, then
  // hands the complete buffer to decodeFrame(). A stall timeout resets it on noise.
  static uint8_t  rxBuffer[RX_BUFFER_SIZE];
  static size_t   rxIndex      = 0;
  static uint32_t rxLastByteMs = 0;   // millis() of last received byte, for stall detection

  while (true) {
    // 1. Process RX (read incoming bytes on UART2)
    while (LoRaSerial.available() > 0) {
      const uint8_t b = static_cast<uint8_t>(LoRaSerial.read());
      rxLastByteMs = millis();

      // --- Sync-byte scanner (positions 0 and 1) ---
      if (rxIndex == 0) {
        // Only 0xAA is accepted as the start byte; anything else is silently discarded.
        if (b == LORA_SYNC_0) {
          rxBuffer[rxIndex++] = b;
        }
        continue;
      }
      if (rxIndex == 1) {
        if (b == LORA_SYNC_1) {
          rxBuffer[rxIndex++] = b;
        } else if (b == LORA_SYNC_0) {
          // 0xAA immediately after 0xAA: keep the new one as the candidate start.
          rxBuffer[0] = b;
          rxIndex = 1;
        } else {
          rxIndex = 0;
        }
        continue;
      }

      // --- Header and payload accumulation (positions 2 onwards) ---
      if (rxIndex < RX_BUFFER_SIZE) {
        rxBuffer[rxIndex++] = b;
      } else {
        // Buffer full with no complete frame: something went wrong. Reset.
        Log_debug("LoRa RX: buffer full without a complete frame, resetting framer");
        rxIndex = 0;
        continue;
      }

      // Once we have the full header (LORA_FRAME_HEADER_LEN bytes) the LEN field is known.
      if (rxIndex < LORA_FRAME_HEADER_LEN) {
        continue;
      }

      const uint8_t payloadLen = rxBuffer[LORA_OFFSET_LEN];
      if (payloadLen > LORA_MAX_PAYLOAD_LEN) {
        Log_debug("LoRa RX: LEN=%u exceeds max, resetting framer", payloadLen);
        rxIndex = 0;
        continue;
      }

      const size_t expectedTotal = LORA_FRAME_HEADER_LEN + payloadLen + LORA_FRAME_CRC_LEN;
      if (rxIndex < expectedTotal) {
        continue;   // still collecting payload / CRC bytes
      }

      // --- Complete frame candidate: validate and dispatch ---
      static LoRaFrame rxFrame;   // static to avoid touching the task stack
      const LoRaDecodeResult result = decodeFrame(rxBuffer, expectedTotal, rxFrame,
                                                  LoRaConfig.getAddress());
      if (result == LoRaDecodeResult::OK) {
        if (self->receiveCallback != nullptr) {
          self->receiveCallback(rxFrame);
        }
        xSemaphoreTake(self->statsMutex, portMAX_DELAY);
        self->statsRxFrames++;
        xSemaphoreGive(self->statsMutex);
        logHex("LoRa RX frame:", rxBuffer, (expectedTotal < 17 ? expectedTotal : 17));
      } else if (result == LoRaDecodeResult::BAD_CRC) {
        xSemaphoreTake(self->statsMutex, portMAX_DELAY);
        self->statsCrcErrors++;
        xSemaphoreGive(self->statsMutex);
      }
      // All other failure codes (BAD_VER, BAD_TYPE, FOREIGN_DST) are logged inside
      // decodeFrame() at DEBUG and silently discarded here (no reply, per protocol §4.3).
      rxIndex = 0;
    }

    // Stall protection: reset a half-received frame that stopped arriving mid-stream.
    if (rxIndex > 0 && (millis() - rxLastByteMs) > RX_FRAME_TIMEOUT_MS) {
      Log_debug("LoRa RX: framer stall timeout (%u bytes buffered), resetting", (unsigned)rxIndex);
      rxIndex = 0;
    }

    // Apply a pending register change (e.g. new air rate). This task owns UART2, so the
    // rewrite happens here. Queued TX frames wait; incoming frames during the ~100 ms of
    // Mode 3 are lost, which is expected while the link parameters change.
    if (self->reconfigRequested.exchange(false)) {
      if (self->configureE220()) {
        Log_info("LoRa runtime reconfiguration applied (air rate %s)", airRateName(LoRaConfig.getAirRate()));
      } else {
        Log_error("LoRa runtime reconfiguration failed - module keeps its previous registers");
      }
      rxIndex = 0;   // drop any half-received frame from before the switch
    }

    // 2. Process TX (drain outgoing queue and transmit)
    if (self->txQueue != nullptr) {
      LoRaTxMessage txMsg;
      if (xQueueReceive(self->txQueue, &txMsg, 0) == pdPASS) {
        self->sendRawInternal(txMsg.destAddr, txMsg.data, txMsg.len);
        // Count every frame that completes the full AUX handshake sequence
        xSemaphoreTake(self->statsMutex, portMAX_DELAY);
        self->statsTxFrames++;
        xSemaphoreGive(self->statsMutex);
      }
    }

    // Yield control to let other core tasks run
    vTaskDelay(pdMS_TO_TICKS(TASK_DELAY_MS));
  }
}
