Warpguru/LoRaIoT/(commit log)

2026-10-24 Fixed that UART mutex does not bracket 2 individual serial write calls
2026-10-27 Refactoring to push-only data flow 4 local and remote (TechDebt.md §8)
2026-10-31 Added MQTT support (publish sensor data, subscribe control data)
2026-11-02 Reworked documentation (added IoT sensor example)
